enigmr/game-console-1/README.md

## Game Console Project 1

Hobby handheld game console from scratch.

## Top View
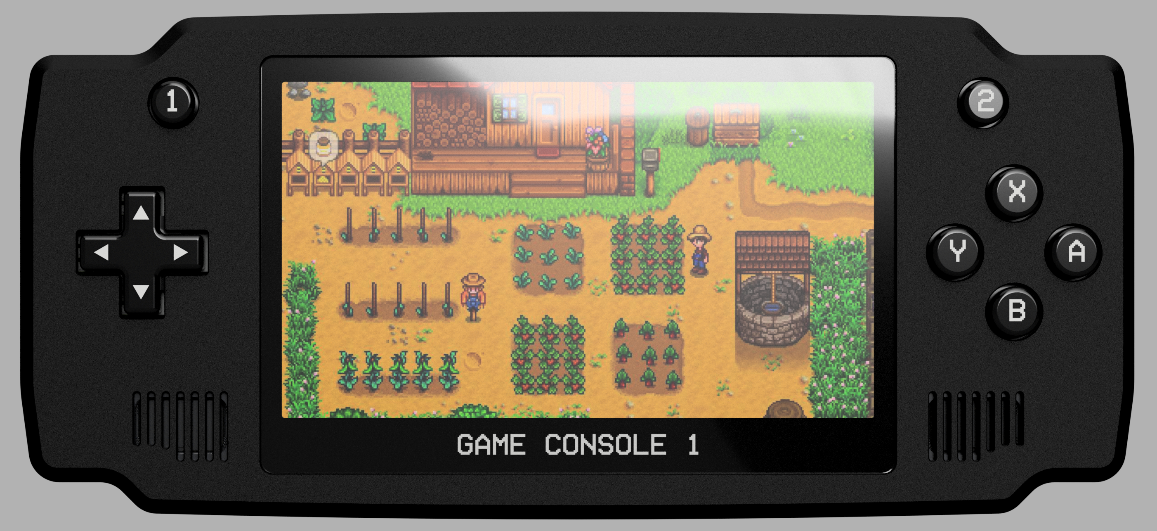
[picture p1: doc/images/mechanicals/render-1.png]


## Insides
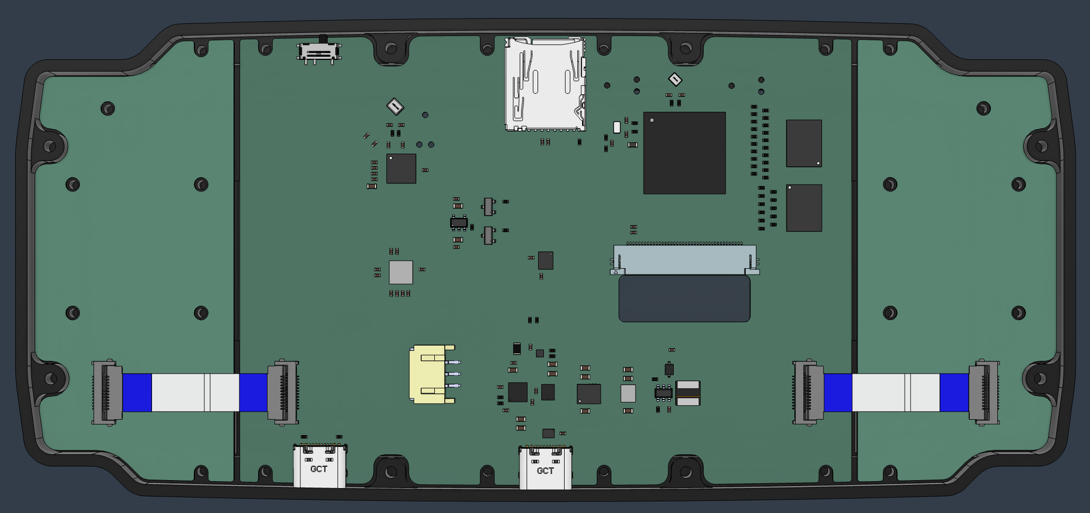
[picture p2: doc/images/mechanicals/insides.png]


## Features

- Display: 4.3", 480x272, 16:9, 1200cd/m2, non-touch
- Processor: STM32N657X0
  - Arm Cortex-M55 @ 800 MHz
  - 2D GPU with scaling, rotating, alpha blending, texture mapping
- RAM:
  - 4.2MB on-chip SRAM
  - 32MB off-chip PSRAM
- Storage:
  - 32MB SLC NOR flash
  - Micro SD card slot
- Audio:
  - Stereo DAC with Class-D amplifiers
  - Stereo 1W speakers
- Haptics:
  - Dual vibration motors
- Input:
  - IMU (accelerometer and gyroscope)
  - D-pad
  - A / B / X / Y buttons
  - Start / Select buttons
- Battery:
  - 500mAh Li-Po battery
- Connectivity:
  - USB-C for charging and accessing storage
  - Wi-Fi and Bluetooth via STM32-C6
- Mechanicals:
  - Machined plastic (material TBD)
- Software:
  - Zephyr RTOS
  - Old game console emulators

## Development Tooling

- Schematics and PCB design: KiCad
- 3D modeling: Fusion 360

## Hardware Block Design

TODO

## PCBs

### Top
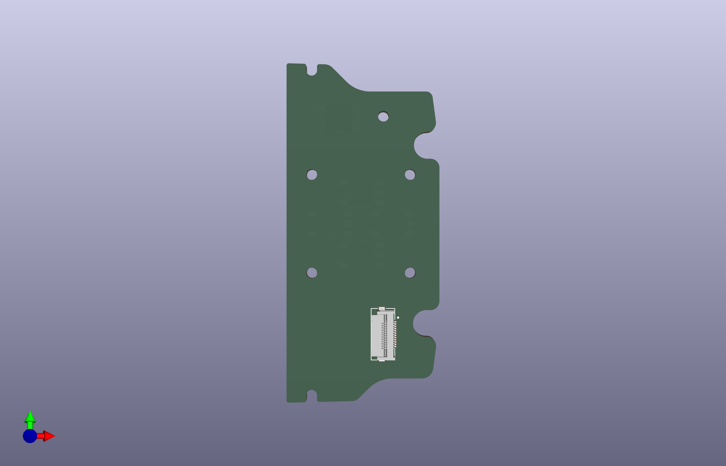
[picture p3: doc/images/pcb/left-board-top.png]

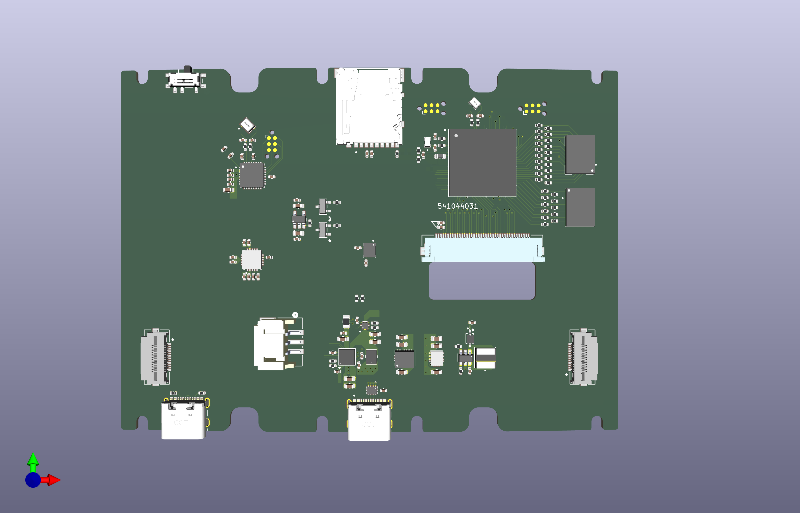
[picture p4: doc/images/pcb/main-board-top.png]

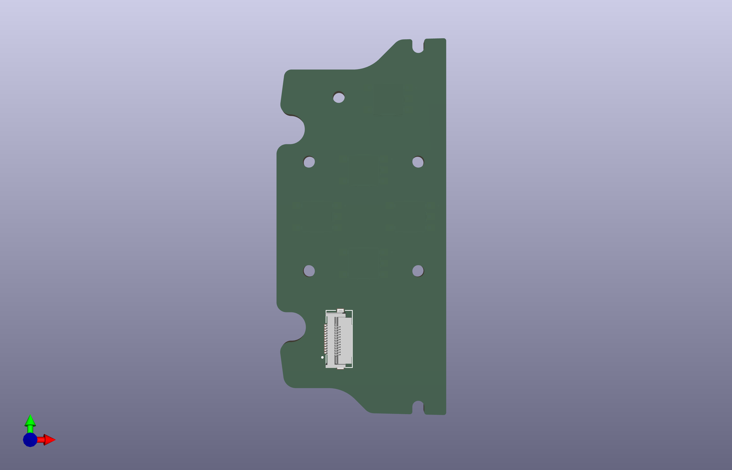
[picture p5: doc/images/pcb/right-board-top.png]


### Top Bottom
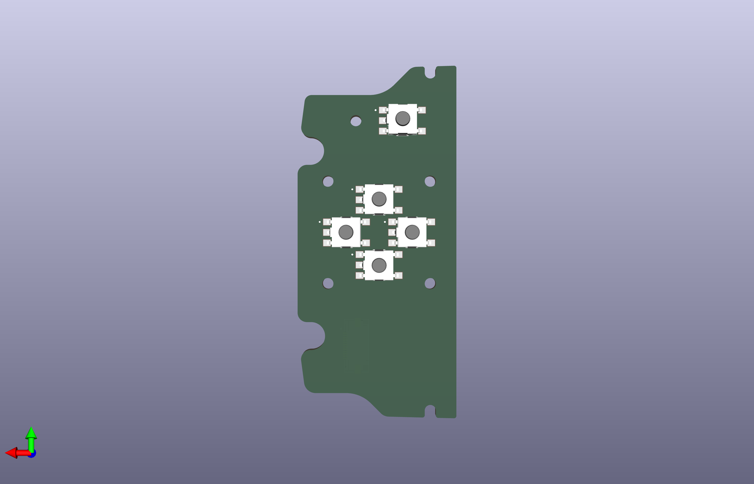
[picture p6: doc/images/pcb/left-board-bottom.png]

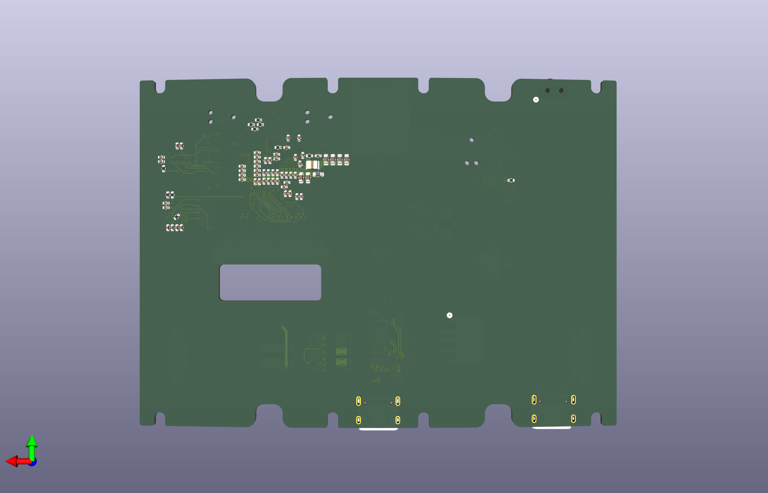
[picture p7: doc/images/pcb/main-board-bottom.png]

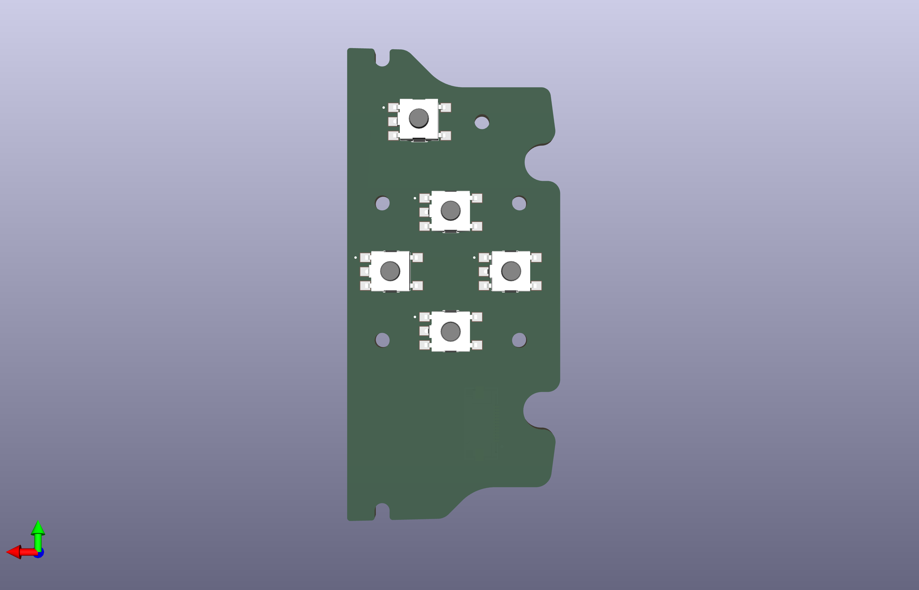
[picture p8: doc/images/pcb/right-board-bottom.png]


## Schematics 

### Top Sheet


### Audio


### ESP32


### Flash


### Haptics


### IMU


### LCD


### MCU


### Micro SD


### Power


### RAM


### USB Switch


### USB


### Controllers


### Left Board


### Right Board
