enigmr/game-console-1/projects/main-board/images/mechanicals/render-1.png

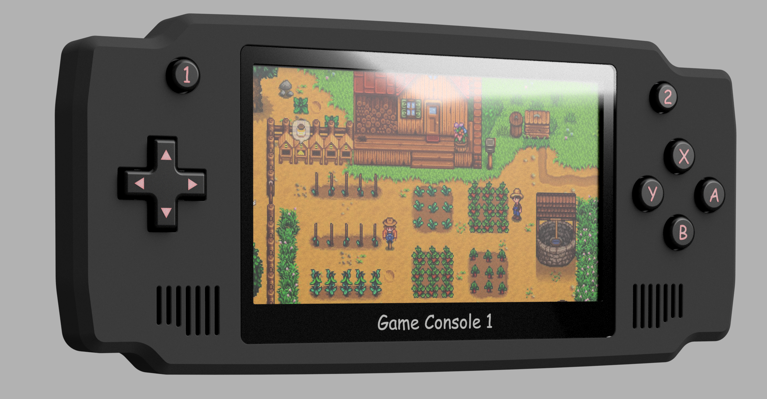
projects/main-board/images/mechanicals/render-1.png
