enigmr/game-console-1/projects/kicad-libraries/3d-models/ABM11W-48.0000MHZ-8-K1Z-T3.stp

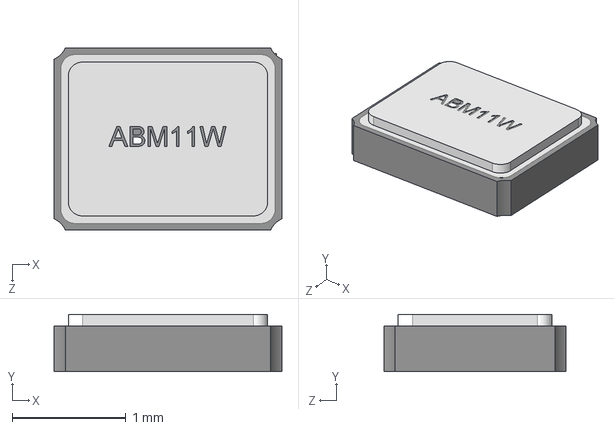
[picture p10: CAD file, 2025-08-03]
projects/kicad-libraries/3d-models/ABM11W-48.0000MHZ-8-K1Z-T3.stp
2.00 x 0.5 x 1.60 mm
