enigmr/game-console-1/projects/kicad-libraries/3d-models/ABS06-32.768KHZ-9-1-T.stp

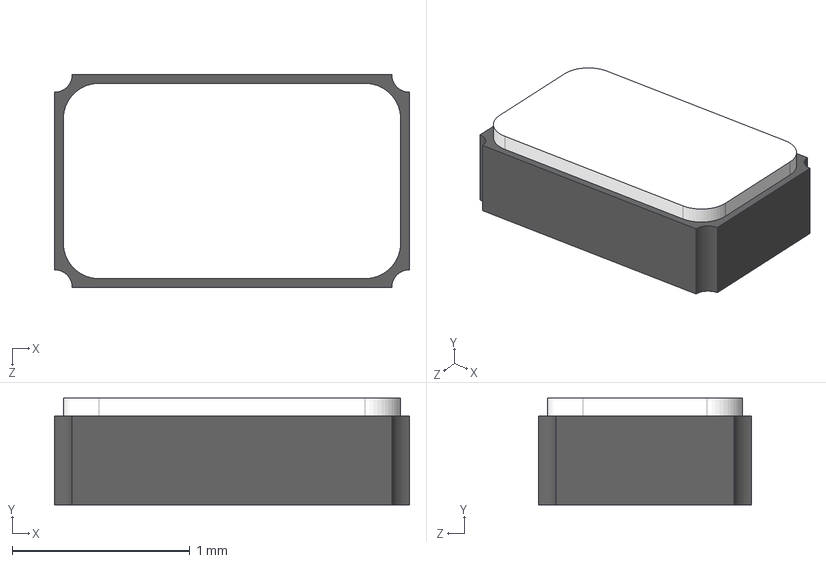
[picture p11: CAD file, 2025-08-03]
projects/kicad-libraries/3d-models/ABS06-32.768KHZ-9-1-T.stp
2.00 x 0.6 x 1.20 mm
