enigmr/game-console-1/projects/kicad-libraries/3d-models/Download_STP_450404015514_rev1.stp

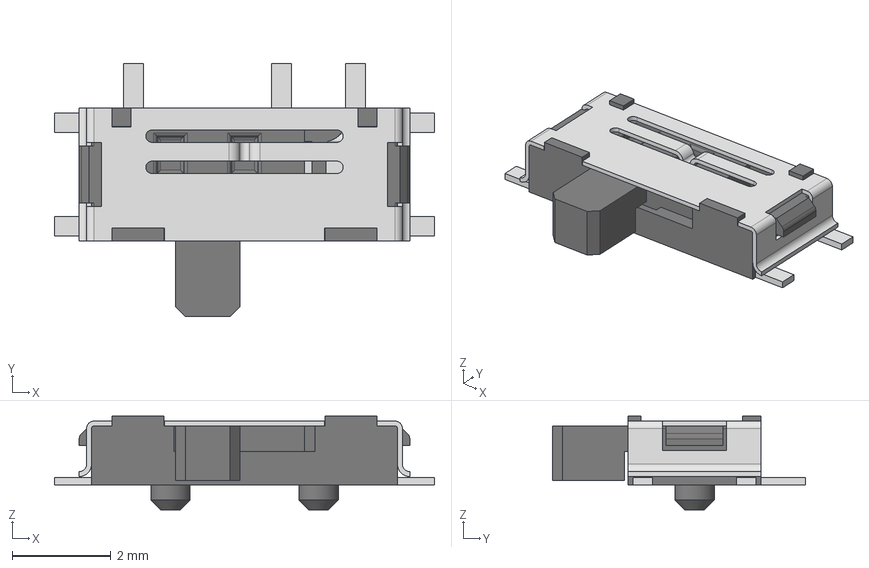
[picture p12: CAD file, 2025-07-27]
projects/kicad-libraries/3d-models/Download_STP_450404015514_rev1.stp
7.70 x 5.13 x 1.90 mm
Frame
Pin 4
Frame 1
Pin 1
Pin 2
Pin 3
Slider 1
Slider
Cover
