enigmr/game-console-1/projects/kicad-libraries/3d-models/IND_0806.step

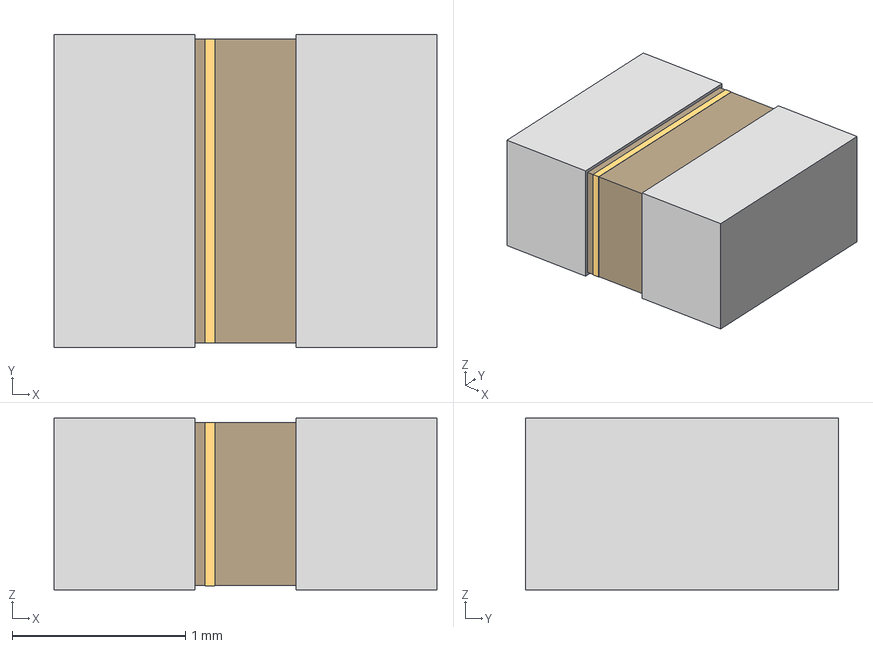
[picture p13: CAD file, 2025-07-27]
projects/kicad-libraries/3d-models/IND_0806.step
2.21 x 1.80 x 0.991 mm
