enigmr/game-console-1/projects/kicad-libraries/3d-models/Same_Sky_TS06-667-25-BK-160-G-SMT-TR.step

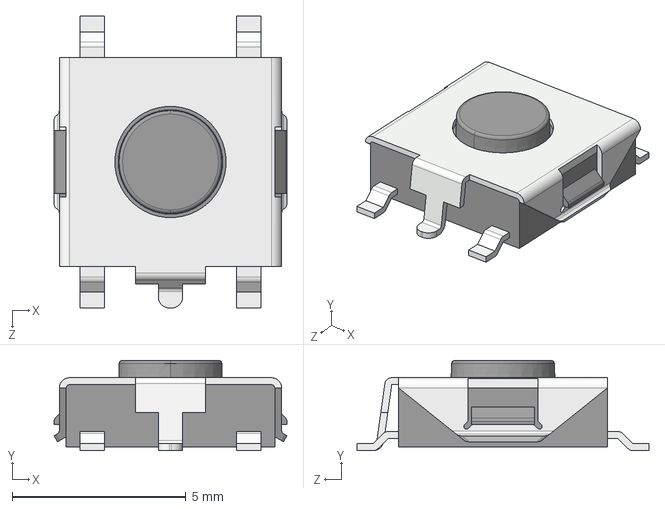
[picture p14: CAD file, 2025-07-27]
projects/kicad-libraries/3d-models/Same_Sky_TS06-667-25-BK-160-G-SMT-TR.step
6.70 x 2.60 x 8.40 mm
