enigmr/game-console-1/projects/kicad-libraries/3d-models/SOD323_DIO.step

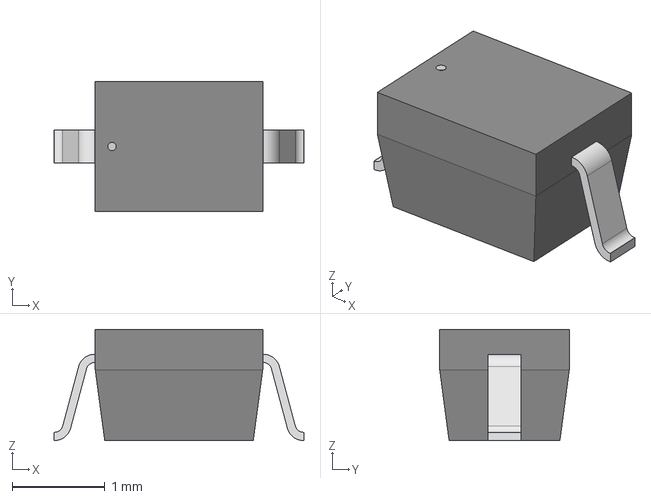
[picture p15: CAD file, 2025-07-27]
projects/kicad-libraries/3d-models/SOD323_DIO.step
2.69 x 1.40 x 1.20 mm
