enigmr/game-console-1/projects/kicad-libraries/3d-models/IND_TAIYO_NR4012_TAY.step

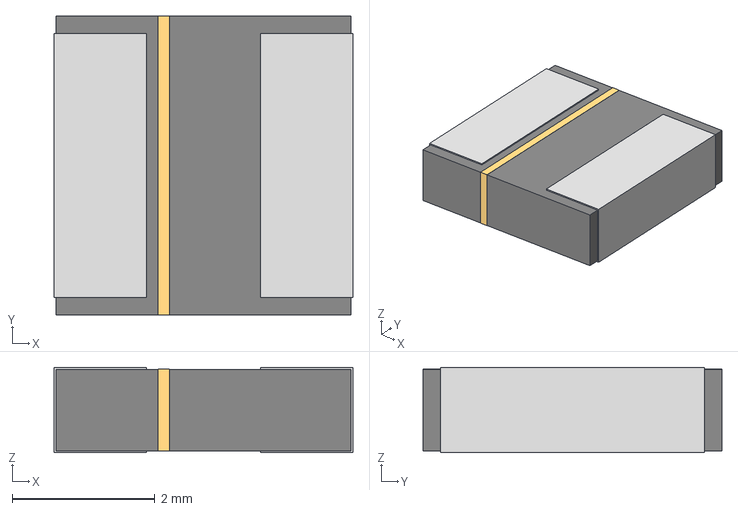
[picture p16: CAD file, 2025-07-27]
projects/kicad-libraries/3d-models/IND_TAIYO_NR4012_TAY.step
4.19 x 4.20 x 1.19 mm
