enigmr/game-console-1/projects/kicad-libraries/3d-models/SOT23_ZXTN_DIO.step

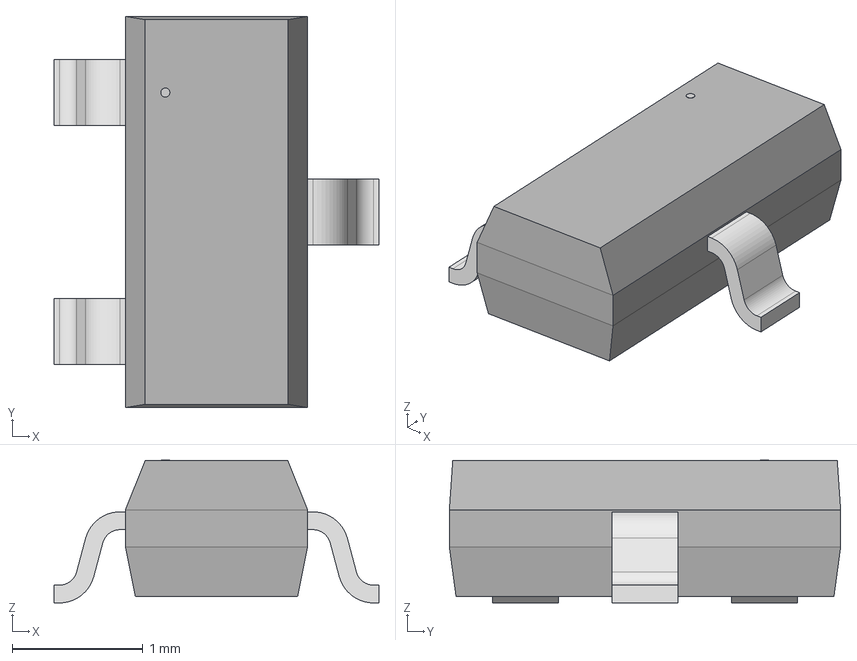
[picture p17: CAD file, 2025-07-27]
projects/kicad-libraries/3d-models/SOT23_ZXTN_DIO.step
2.49 x 3.00 x 1.09 mm
