enigmr/game-console-1/projects/kicad-libraries/3d-models/S3B-PH-SM4-TB_LF__SN_.stp

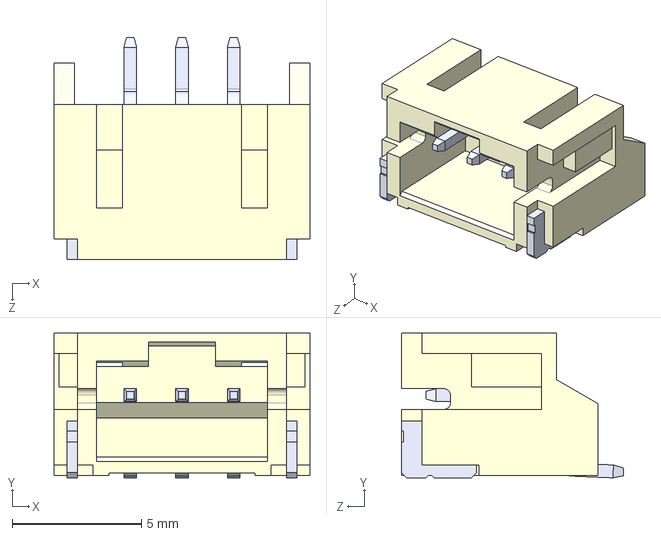
[picture p18: CAD file, 2025-07-27]
projects/kicad-libraries/3d-models/S3B-PH-SM4-TB_LF__SN_.stp
9.90 x 5.60 x 8.60 mm
