enigmr/game-console-1/projects/kicad-libraries/3d-models/IND_HMLQ25201T_CYN.step

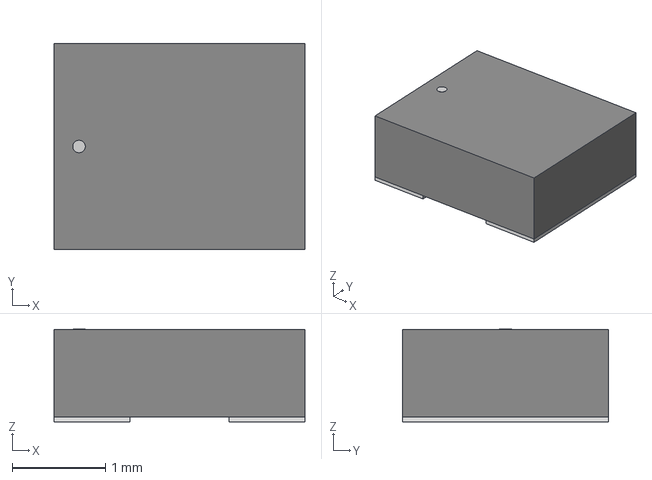
[picture p19: CAD file, 2025-07-27]
projects/kicad-libraries/3d-models/IND_HMLQ25201T_CYN.step
2.69 x 2.21 x 0.993 mm
