enigmr/game-console-1/projects/kicad-libraries/3d-models/STM32N645A0HxQ.step

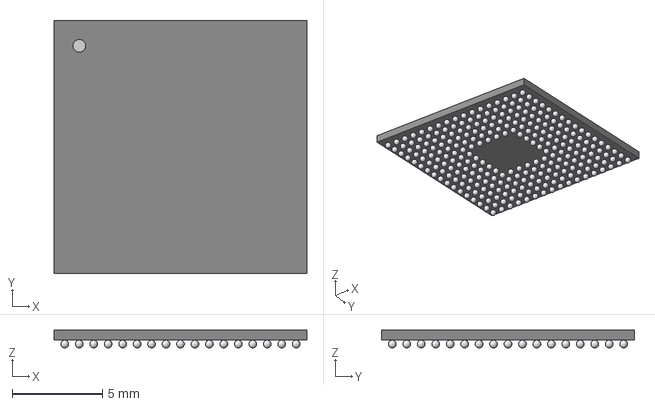
[picture p20: CAD file, 2025-07-26]
projects/kicad-libraries/3d-models/STM32N645A0HxQ.step
14.0 x 14.0 x 0.993 mm
