enigmr/game-console-1/projects/kicad-libraries/3d-models/MX25UM51245GXDI00.STEP

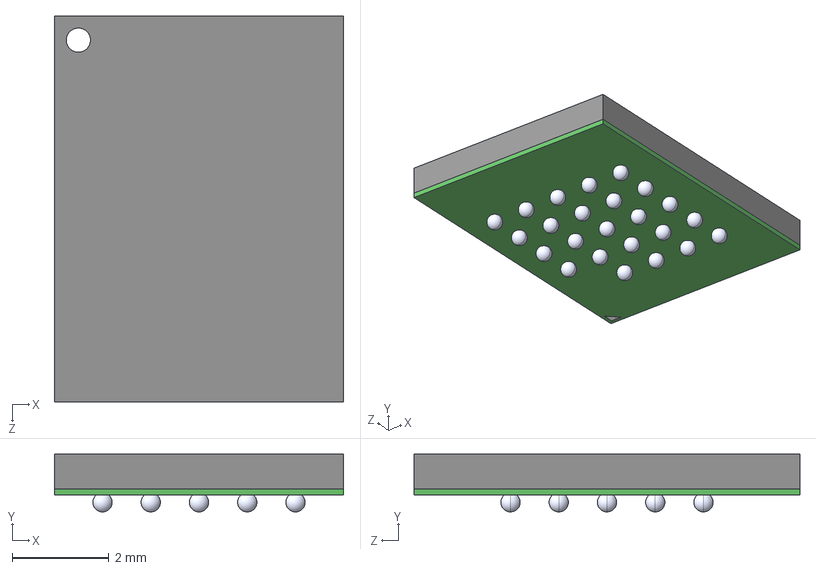
[picture p21: CAD file, 2025-07-26]
projects/kicad-libraries/3d-models/MX25UM51245GXDI00.STEP
6.00 x 1.20 x 8.00 mm
Body^MX25LM51245GXDI00
ball^MX25LM51245GXDI00 x 24
