enigmr/game-console-1/projects/kicad-libraries/3d-models/TPSM863253RDXR--3DModel-STEP-740395.STEP

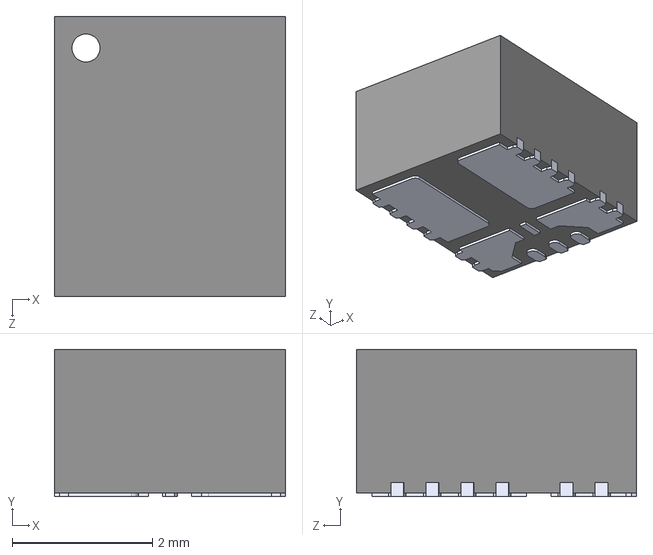
[picture p22: CAD file, 2025-07-26]
projects/kicad-libraries/3d-models/TPSM863253RDXR--3DModel-STEP-740395.STEP
3.30 x 2.10 x 4.00 mm
