enigmr/game-console-1/projects/kicad-libraries/3d-models/AP5725WG-7.STEP

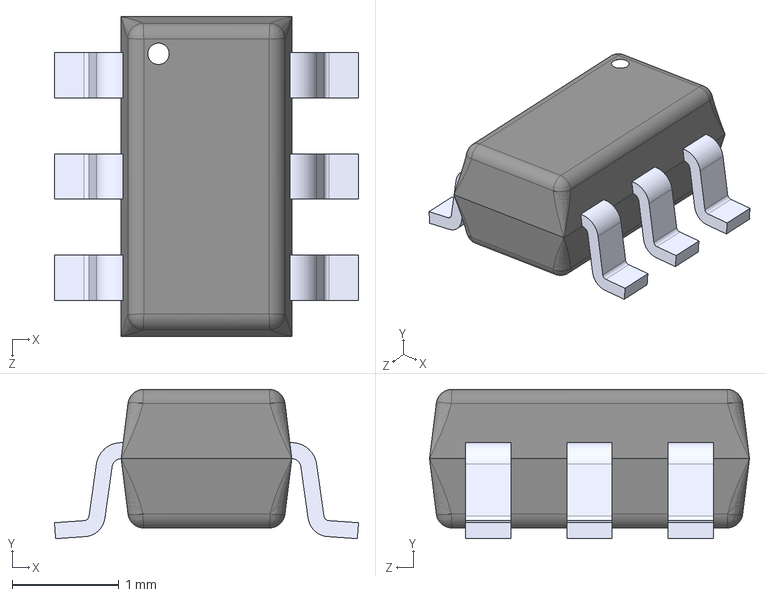
[picture p23: CAD file, 2025-07-26]
projects/kicad-libraries/3d-models/AP5725WG-7.STEP
2.85 x 1.40 x 3.00 mm
