enigmr/game-console-1/projects/kicad-libraries/3d-models/ESP32-C6FH4--3DModel-STEP-56544.STEP

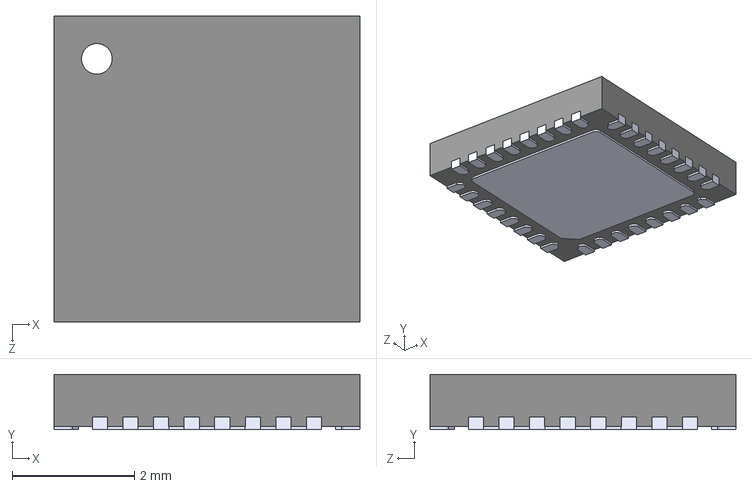
[picture p24: CAD file, 2025-07-26]
projects/kicad-libraries/3d-models/ESP32-C6FH4--3DModel-STEP-56544.STEP
5.00 x 0.9 x 5.00 mm
