enigmr/game-console-1/projects/kicad-libraries/3d-models/APS256XXN-OBR-BG--3DModel-STEP-269445.STEP

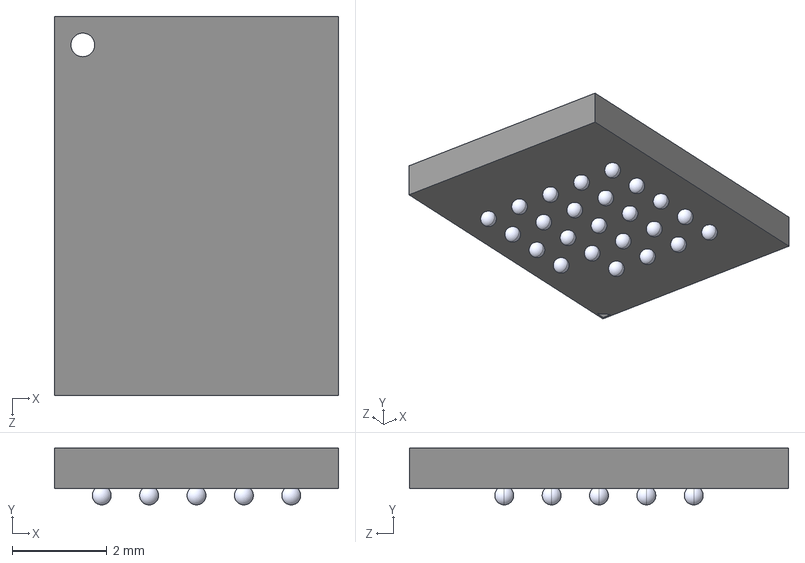
[picture p25: CAD file, 2025-07-26]
projects/kicad-libraries/3d-models/APS256XXN-OBR-BG--3DModel-STEP-269445.STEP
6.00 x 1.20 x 8.00 mm
