enigmr/game-console-1/projects/kicad-libraries/3d-models/LSM6DSO32TR--3DModel-STEP-269445.STEP

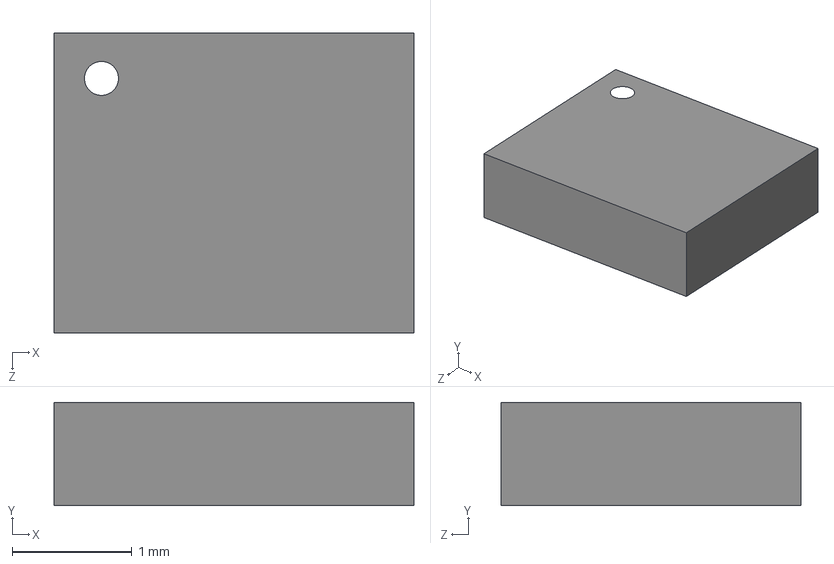
[picture p26: CAD file, 2025-07-26]
projects/kicad-libraries/3d-models/LSM6DSO32TR--3DModel-STEP-269445.STEP
3.00 x 0.86 x 2.50 mm
