enigmr/game-console-1/projects/kicad-libraries/3d-models/MPM3805GQB-18-Z v1.step

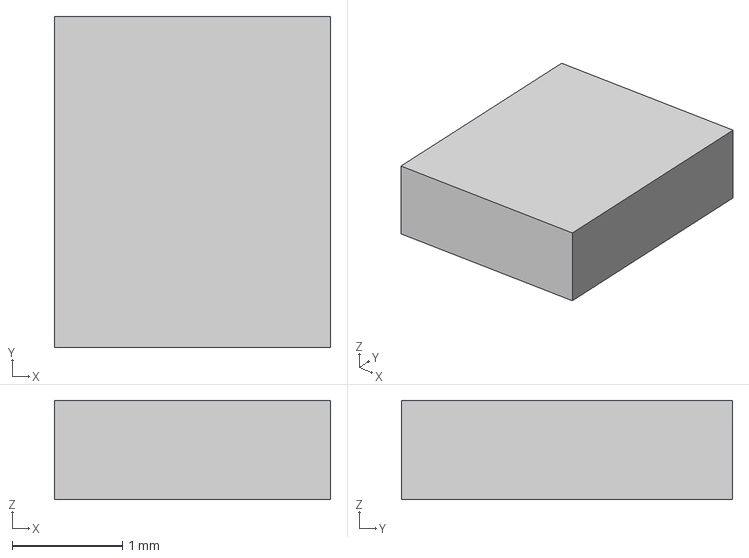
[picture p27: CAD file, 2025-07-26]
projects/kicad-libraries/3d-models/MPM3805GQB-18-Z v1.step
2.50 x 3.00 x 0.9 mm
