enigmr/game-console-1/projects/kicad-libraries/3d-models/USB4105-GF-A.stp

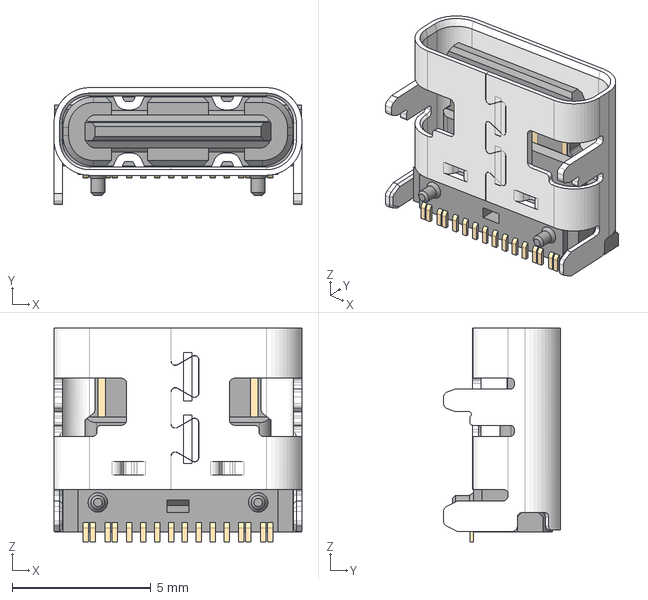
[picture p28: CAD file, 2025-07-26]
projects/kicad-libraries/3d-models/USB4105-GF-A.stp
8.94 x 4.21 x 7.70 mm
USB4105-GF-A_PART1
USB4105-GF-A_PART2
