enigmr/game-console-1/projects/kicad-libraries/3d-models/ABM10W-40.0000MHZ-8-B1U-T3--3DModel-STEP-400430.STEP

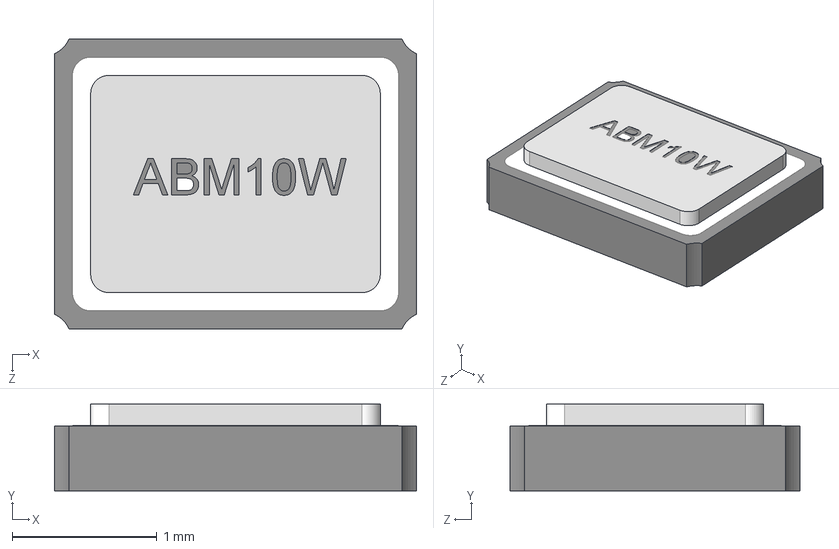
[picture p29: CAD file, 2025-07-26]
projects/kicad-libraries/3d-models/ABM10W-40.0000MHZ-8-B1U-T3--3DModel-STEP-400430.STEP
2.50 x 0.6 x 2.00 mm
