enigmr/game-console-1/projects/kicad-libraries/3d-models/TS3USB221ARSER.STEP

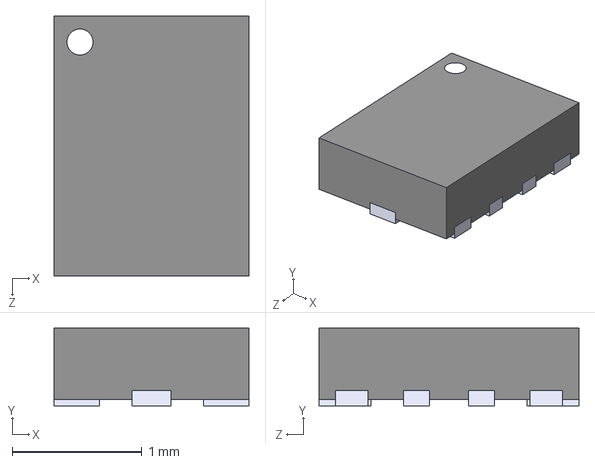
[picture p30: CAD file, 2025-07-26]
projects/kicad-libraries/3d-models/TS3USB221ARSER.STEP
1.50 x 0.6 x 2.00 mm
