enigmr/game-console-1/projects/kicad-libraries/3d-models/dm3at-sf-pejm5.stp

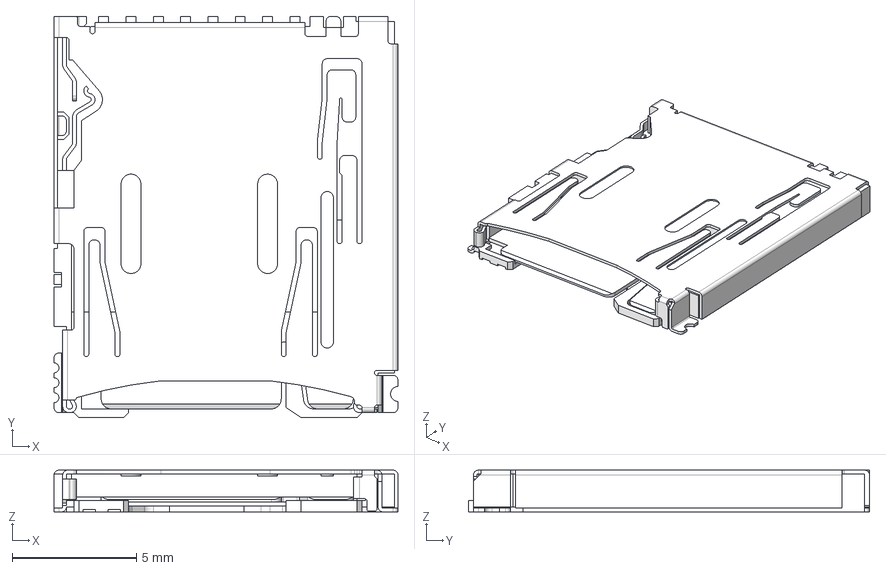
[picture p31: CAD file, 2025-07-26]
projects/kicad-libraries/3d-models/dm3at-sf-pejm5.stp
13.8 x 16.2 x 1.68 mm
