enigmr/game-console-1/(list of files, cad)

Other CAD files:
projects/kicad-libraries/3d-models/5051101292.stp
projects/kicad-libraries/3d-models/541044031.stp
projects/kicad-libraries/3d-models/MAX77972EWX+T.step
projects/kicad-libraries/3d-models/TLV74330PDBVR.STEP
projects/kicad-libraries/3d-models/TPS22992SRXNR--3DModel-STEP-56544.STEP
projects/kicad-libraries/3d-models/TPS92380PWPR--3DModel-STEP-56544.STEP
