enigmr/game-console-1/projects/main-board/main-board.kicad_pcb

## KiCad design projects/main-board/main-board.kicad_pcb (2025-08-25)

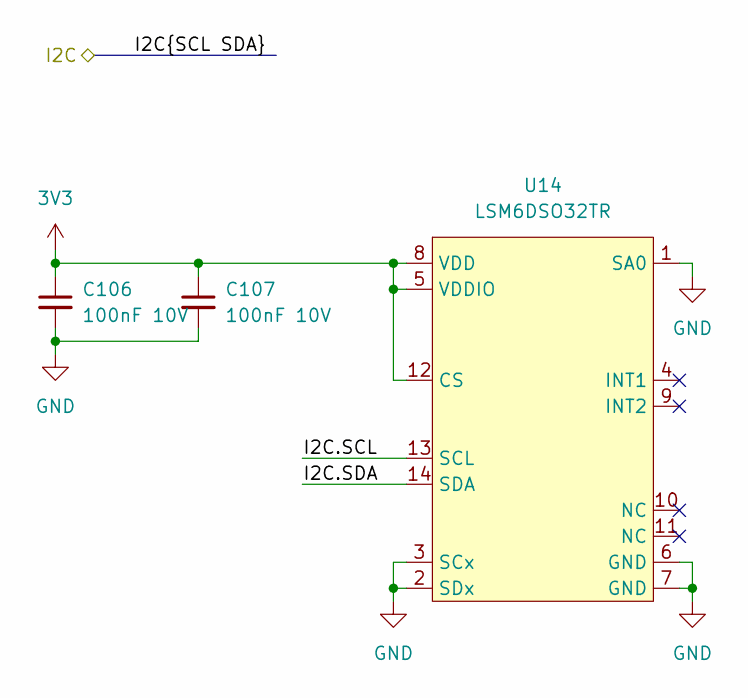
[picture p32: schematic imu.kicad_sch]

Parts:
C106, C107: 100nF 10V; C_0402_1005Metric
U14: LSM6DSO32TR

Connections:
3V3: C106.1, C107.1, U14.5 (VDDIO), U14.8 (VDD), U14.12 (CS); also elsewhere on the board
/Audio/I2C.SCL: U14.13 (SCL); also elsewhere on the board
/Audio/I2C.SDA: U14.14 (SDA); also elsewhere on the board
GND: C106.2, C107.2, U14.1 (SA0), U14.2 (SDx), U14.3 (SCx), U14.6 (GND), U14.7 (GND); also elsewhere on the board

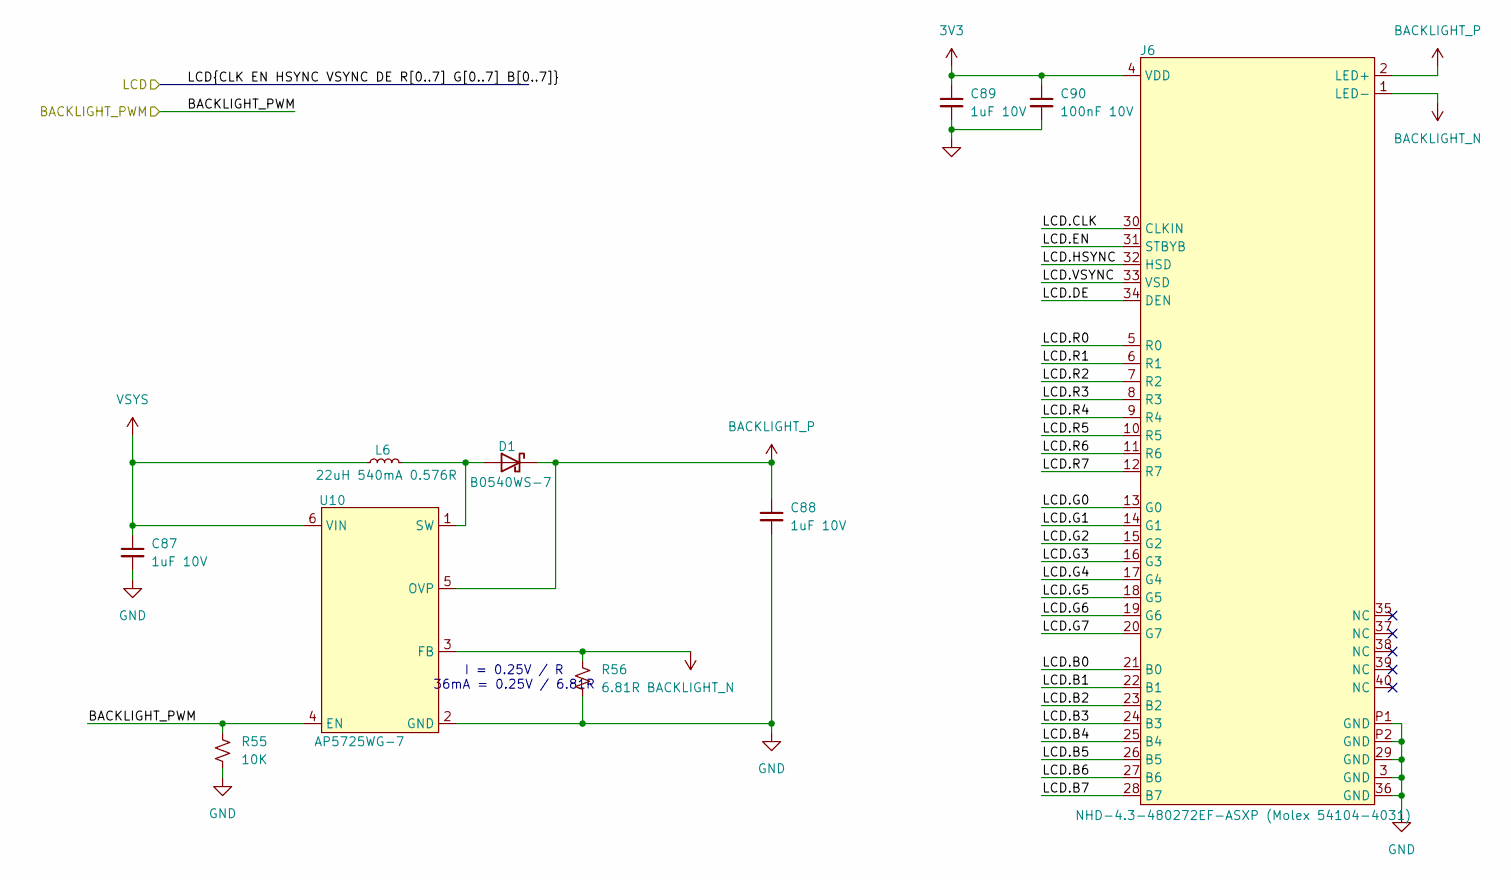
[picture p33: schematic lcd.kicad_sch]

Parts:
C87, C88, C89: 1uF 10V; C_0402_1005Metric
C90: 100nF 10V; C_0402_1005Metric
D1: B0540WS-7; SOD323_DIO
J6: NHD-4.3-480272EF-ASXP (Molex 54104-4031); Molex 54104-4031
L6: 22uH 540mA 0.576R; NR4012T220M
R55: 10K; R_0402_1005Metric
R56: 6.81R; R_0402_1005Metric
U10: AP5725WG-7

Connections:
3V3: C89.1, C90.1, J6.4 (VDD); also elsewhere on the board
/LCD/BACKLIGHT_PWM: R55.1, U10.4 (EN); also elsewhere on the board
/LCD/LCD.B0: J6.21 (B0); also elsewhere on the board
/LCD/LCD.B1: J6.22 (B1); also elsewhere on the board
/LCD/LCD.B2: J6.23 (B2); also elsewhere on the board
/LCD/LCD.B3: J6.24 (B3); also elsewhere on the board
/LCD/LCD.B4: J6.25 (B4); also elsewhere on the board
/LCD/LCD.B5: J6.26 (B5); also elsewhere on the board
/LCD/LCD.B6: J6.27 (B6); also elsewhere on the board
/LCD/LCD.B7: J6.28 (B7); also elsewhere on the board
/LCD/LCD.CLK: J6.30 (CLKIN); also elsewhere on the board
/LCD/LCD.DE: J6.34 (DEN); also elsewhere on the board
/LCD/LCD.EN: J6.31 (STBYB); also elsewhere on the board
/LCD/LCD.G0: J6.13 (G0); also elsewhere on the board
/LCD/LCD.G1: J6.14 (G1); also elsewhere on the board
/LCD/LCD.G2: J6.15 (G2); also elsewhere on the board
/LCD/LCD.G3: J6.16 (G3); also elsewhere on the board
/LCD/LCD.G4: J6.17 (G4); also elsewhere on the board
/LCD/LCD.G5: J6.18 (G5); also elsewhere on the board
/LCD/LCD.G6: J6.19 (G6); also elsewhere on the board
/LCD/LCD.G7: J6.20 (G7); also elsewhere on the board
/LCD/LCD.HSYNC: J6.32 (HSD); also elsewhere on the board
/LCD/LCD.R0: J6.5 (R0); also elsewhere on the board
/LCD/LCD.R1: J6.6 (R1); also elsewhere on the board
/LCD/LCD.R2: J6.7 (R2); also elsewhere on the board
/LCD/LCD.R3: J6.8 (R3); also elsewhere on the board
/LCD/LCD.R4: J6.9 (R4); also elsewhere on the board
/LCD/LCD.R5: J6.10 (R5); also elsewhere on the board
/LCD/LCD.R6: J6.11 (R6); also elsewhere on the board
/LCD/LCD.R7: J6.12 (R7); also elsewhere on the board
/LCD/LCD.VSYNC: J6.33 (VSD); also elsewhere on the board
BACKLIGHT_N: J6.1 (LED-), R56.1, U10.3 (FB)
BACKLIGHT_P: C88.1, D1.1 (K), J6.2 (LED+), U10.5 (OVP)
GND: C87.2, C88.2, C89.2, C90.2, J6.3 (GND), J6.29 (GND), J6.36 (GND), J6.P1 (GND), J6.P2 (GND), R55.2, R56.2, U10.2 (GND); also elsewhere on the board
unnamed: D1.2 (A), L6.2, U10.1 (SW)
VSYS: C87.1, L6.1, U10.6 (VIN); also elsewhere on the board

Notes on the sheet:
I = 0.25V / R 36mA = 0.25V / 6.81R

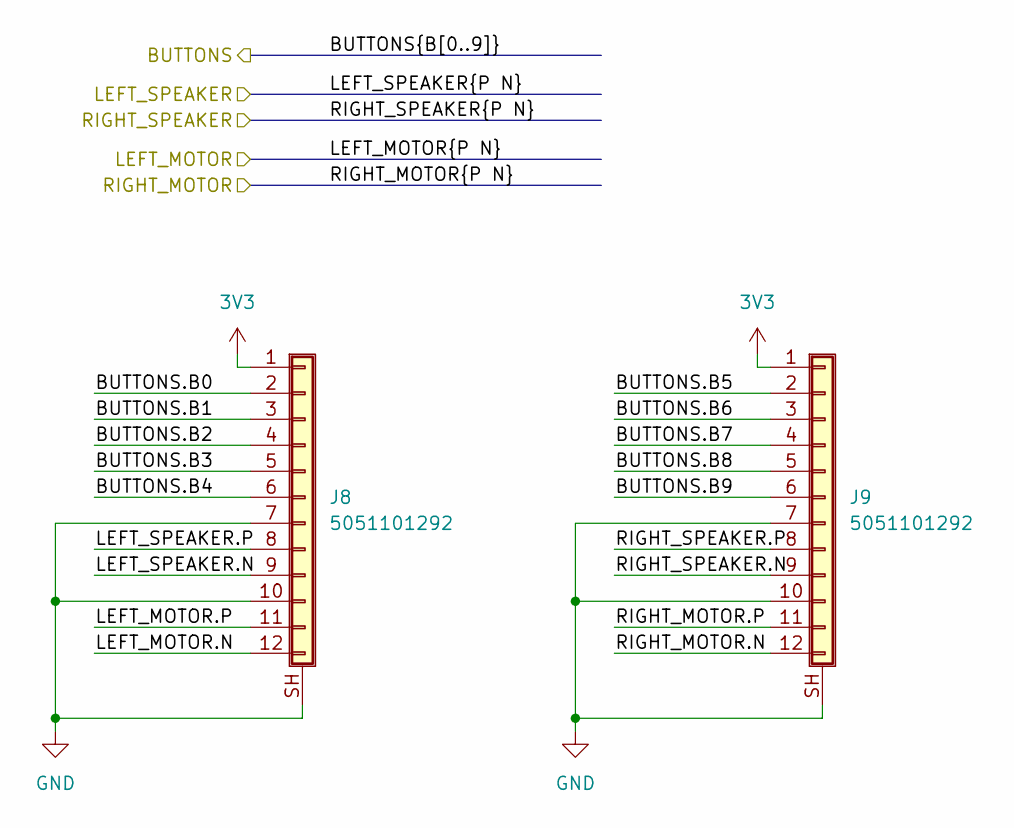
[picture p34: schematic controllers.kicad_sch]

Parts:
J8, J9: 5051101292

Connections:
3V3: J8.1, J9.1; also elsewhere on the board
/Audio/LEFT_SPEAKER.N: J8.9; also elsewhere on the board
/Audio/LEFT_SPEAKER.P: J8.8; also elsewhere on the board
/Audio/RIGHT_SPEAKER.N: J9.9; also elsewhere on the board
/Audio/RIGHT_SPEAKER.P: J9.8; also elsewhere on the board
/Controllers/BUTTONS.B0: J8.2; also elsewhere on the board
/Controllers/BUTTONS.B1: J8.3; also elsewhere on the board
/Controllers/BUTTONS.B2: J8.4; also elsewhere on the board
/Controllers/BUTTONS.B3: J8.5; also elsewhere on the board
/Controllers/BUTTONS.B4: J8.6; also elsewhere on the board
/Controllers/BUTTONS.B5: J9.2; also elsewhere on the board
/Controllers/BUTTONS.B6: J9.3; also elsewhere on the board
/Controllers/BUTTONS.B7: J9.4; also elsewhere on the board
/Controllers/BUTTONS.B8: J9.5; also elsewhere on the board
/Controllers/BUTTONS.B9: J9.6; also elsewhere on the board
/Controllers/LEFT_MOTOR.N: J8.12; also elsewhere on the board
/Controllers/LEFT_MOTOR.P: J8.11; also elsewhere on the board
/Controllers/RIGHT_MOTOR.N: J9.12; also elsewhere on the board
/Controllers/RIGHT_MOTOR.P: J9.11
GND: J8.7, J8.10, J8.SH (Shield), J9.7, J9.10, J9.SH (Shield); also elsewhere on the board

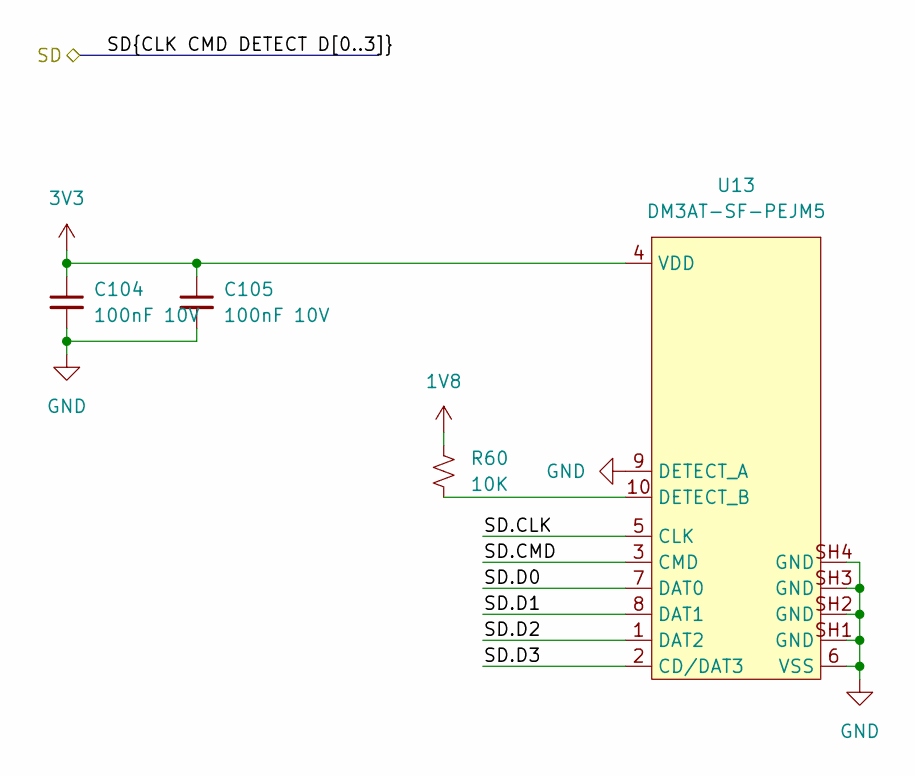
[picture p35: schematic micro-sd.kicad_sch]

Parts:
C104, C105: 100nF 10V; C_0402_1005Metric
R60: 10K; R_0402_1005Metric
U13: DM3AT-SF-PEJM5

Connections:
1V8: R60.1; also elsewhere on the board
3V3: C104.1, C105.1, U13.4 (VDD); also elsewhere on the board
/MCU/SD.CLK: U13.5 (CLK); also elsewhere on the board
/MCU/SD.CMD: U13.3 (CMD); also elsewhere on the board
/MCU/SD.D0: U13.7 (DAT0); also elsewhere on the board
/MCU/SD.D1: U13.8 (DAT1); also elsewhere on the board
/MCU/SD.D2: U13.1 (DAT2); also elsewhere on the board
/MCU/SD.D3: U13.2 (CD/DAT3); also elsewhere on the board
GND: C104.2, C105.2, U13.6 (VSS), U13.9 (DETECT_A), U13.SH1 (GND), U13.SH2 (GND), U13.SH3 (GND), U13.SH4 (GND); also elsewhere on the board
unnamed: R60.2, U13.10 (DETECT_B)

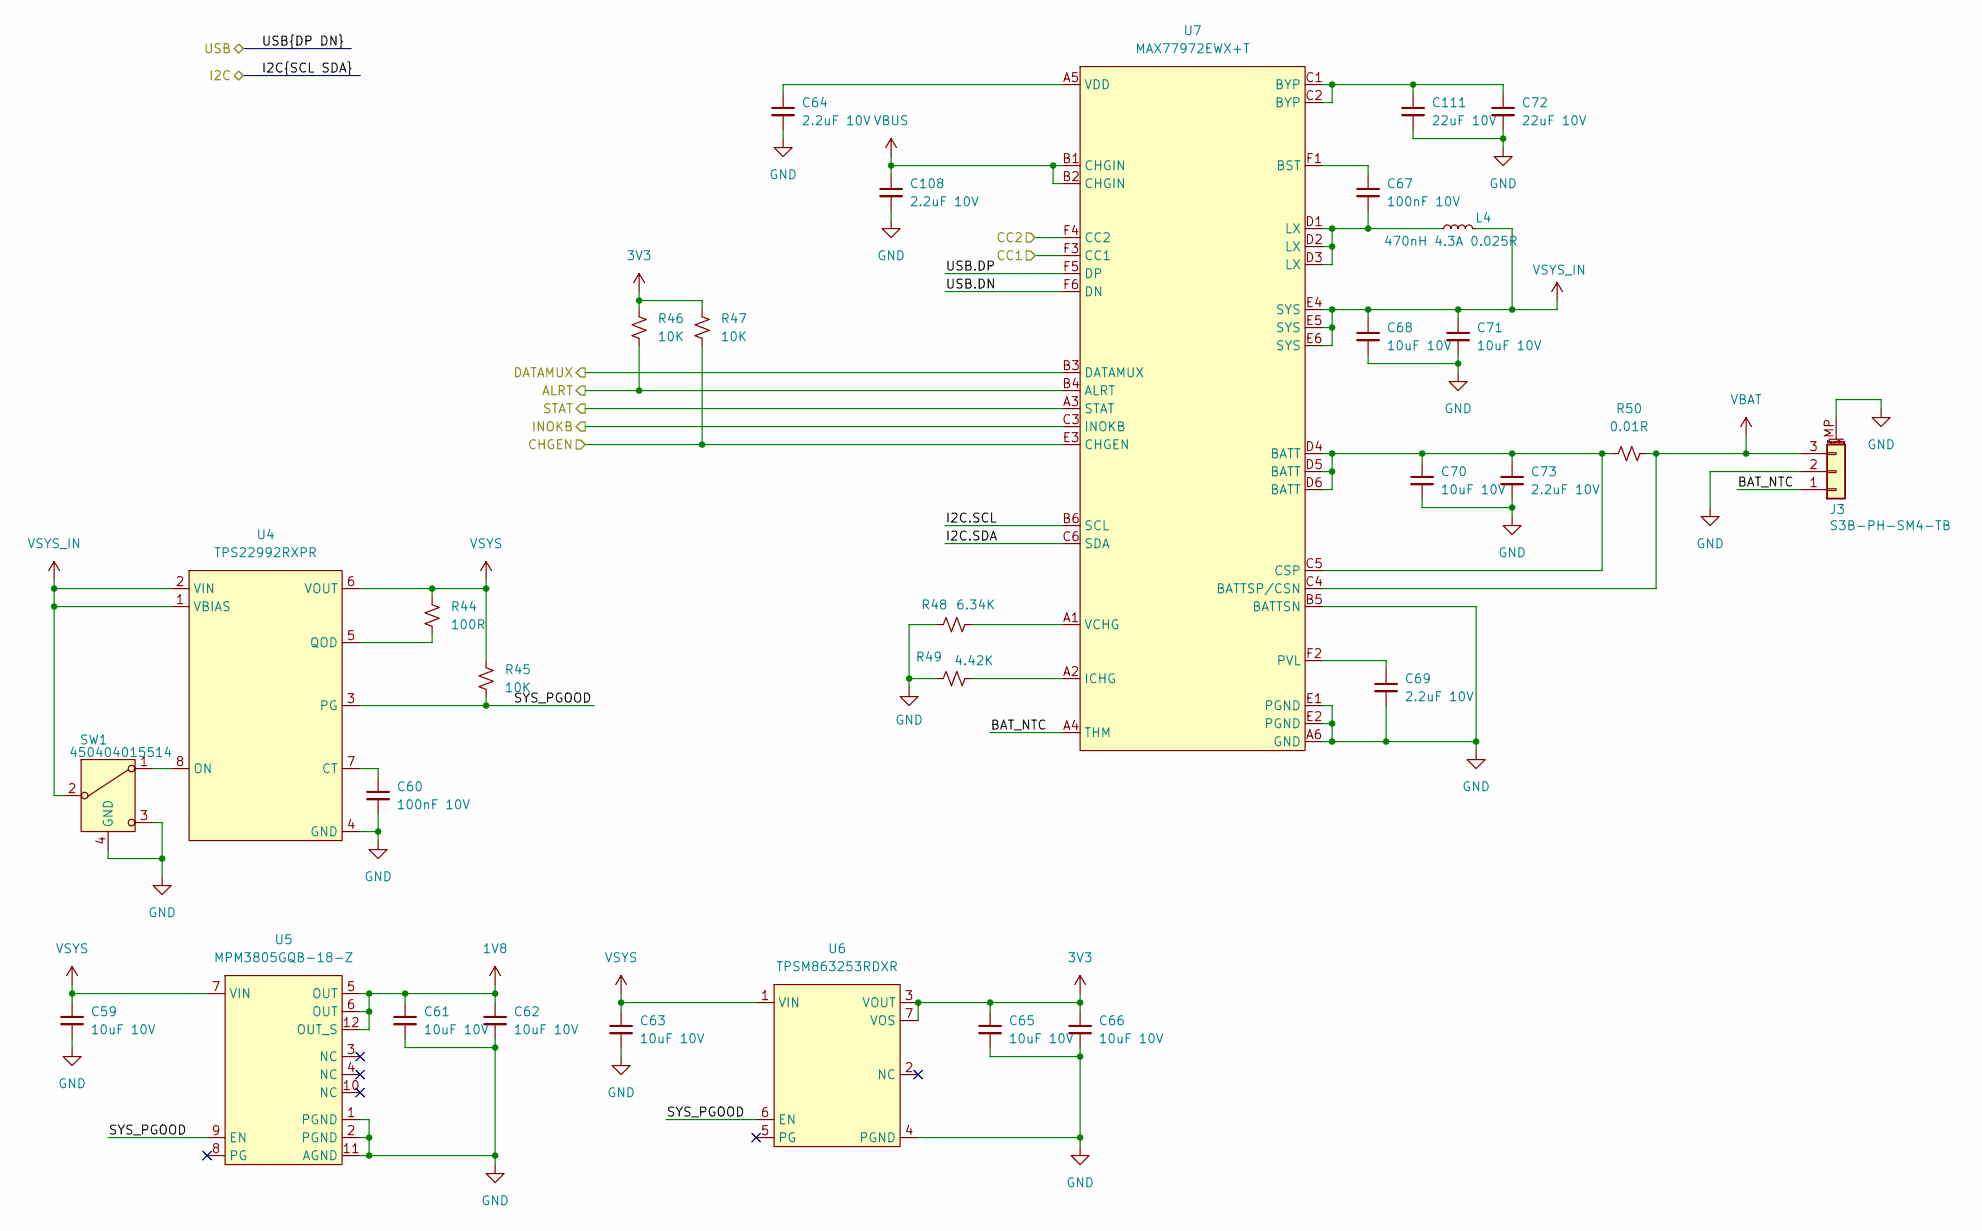
[picture p36: schematic pmic.kicad_sch]

Parts:
C59, C61, C62, C63, C65, C66, C68, C70, C71: 10uF 10V; C_0603_1608Metric
C60, C67: 100nF 10V; C_0402_1005Metric
C64, C69, C73, C108: 2.2uF 10V; C_0402_1005Metric
C72, C111: 22uF 10V; C_0603_1608Metric
J3: S3B-PH-SM4-TB
L4: 470nH 4.3A 0.025R; HMLQ25201T-R47MSR
R44: 100R; R_0402_1005Metric
R45, R46, R47: 10K; R_0402_1005Metric
R48: 6.34K; R_0402_1005Metric
R49: 4.42K; R_0402_1005Metric
R50: 0.01R; R_0805_2012Metric
SW1: 450404015514
U4: TPS22992RXPR
U5: MPM3805GQB-18-Z
U6: TPSM863253RDXR
U7: MAX77972EWX+T

Connections:
1V8: C61.1, C62.1, U5.5 (OUT), U5.6 (OUT), U5.12 (OUT_S); also elsewhere on the board
3V3: C65.1, C66.1, R46.1, R47.1, U6.3 (VOUT), U6.7 (VOS); also elsewhere on the board
/MCU/I2C4.SCL: U7.B6 (SCL); also elsewhere on the board
/MCU/I2C4.SDA: U7.C6 (SDA); also elsewhere on the board
/MCU/PMIC_ALERT: R46.2, U7.B4 (ALRT); also elsewhere on the board
/MCU/PMIC_CHARGE_EN: R47.2, U7.E3 (CHGEN); also elsewhere on the board
/MCU/PMIC_INPUT_VALID: U7.C3 (INOKB); also elsewhere on the board
/MCU/PMIC_STATUS: U7.A3 (STAT); also elsewhere on the board
/Power/BAT_NTC: J3.1, U7.A4 (THM)
/Power/DATAMUX: U7.B3 (DATAMUX); also elsewhere on the board
/Power/SYS_PGOOD: R45.2, U4.3 (PG), U5.9 (EN), U6.6 (EN)
/Power/USB.DN: U7.F6 (DN); also elsewhere on the board
/Power/USB.DP: U7.F5 (DP); also elsewhere on the board
/USB/USB_CC1: U7.F3 (CC1); also elsewhere on the board
/USB/USB_CC2: U7.F4 (CC2); also elsewhere on the board
GND: C59.2, C60.2, C61.2, C62.2, C63.2, C64.2, C65.2, C66.2, C68.2, C69.2, C70.2, C71.2, C72.2, C73.2, C108.2, C111.2, J3.2, J3.MP (MountPin), R48.1, R49.1, SW1.3, SW1.4 (GND), U4.4 (GND), U5.1 (PGND), U5.2 (PGND), U5.11 (AGND), U6.4 (PGND), U7.A6 (GND), U7.B5 (BATTSN), U7.E1 (PGND), U7.E2 (PGND); also elsewhere on the board
unnamed: C67.2, L4.1, U7.D1 (LX), U7.D2 (LX), U7.D3 (LX)
unnamed: C72.1, C111.1, U7.C1 (BYP), U7.C2 (BYP)
unnamed: C60.1, U4.7 (CT)
unnamed: SW1.1, U4.8 (ON)
unnamed: R44.2, U4.5 (QOD)
unnamed: C67.1, U7.F1 (BST)
unnamed: C70.1, C73.1, R50.1, U7.C5 (CSP), U7.D4 (BATT), U7.D5 (BATT), U7.D6 (BATT)
unnamed: R49.2, U7.A2 (ICHG)
unnamed: C69.1, U7.F2 (PVL)
unnamed: R48.2, U7.A1 (VCHG)
unnamed: C64.1, U7.A5 (VDD)
VBAT: J3.3, R50.2, U7.C4 (BATTSP/CSN); also elsewhere on the board
VBUS: C108.1, U7.B1 (CHGIN), U7.B2 (CHGIN); also elsewhere on the board
VSYS: C59.1, C63.1, R44.1, R45.1, U4.6 (VOUT), U5.7 (VIN), U6.1 (VIN); also elsewhere on the board
VSYS_IN: C68.1, C71.1, L4.2, SW1.2, U4.1 (VBIAS), U4.2 (VIN), U7.E4 (SYS), U7.E5 (SYS), U7.E6 (SYS)

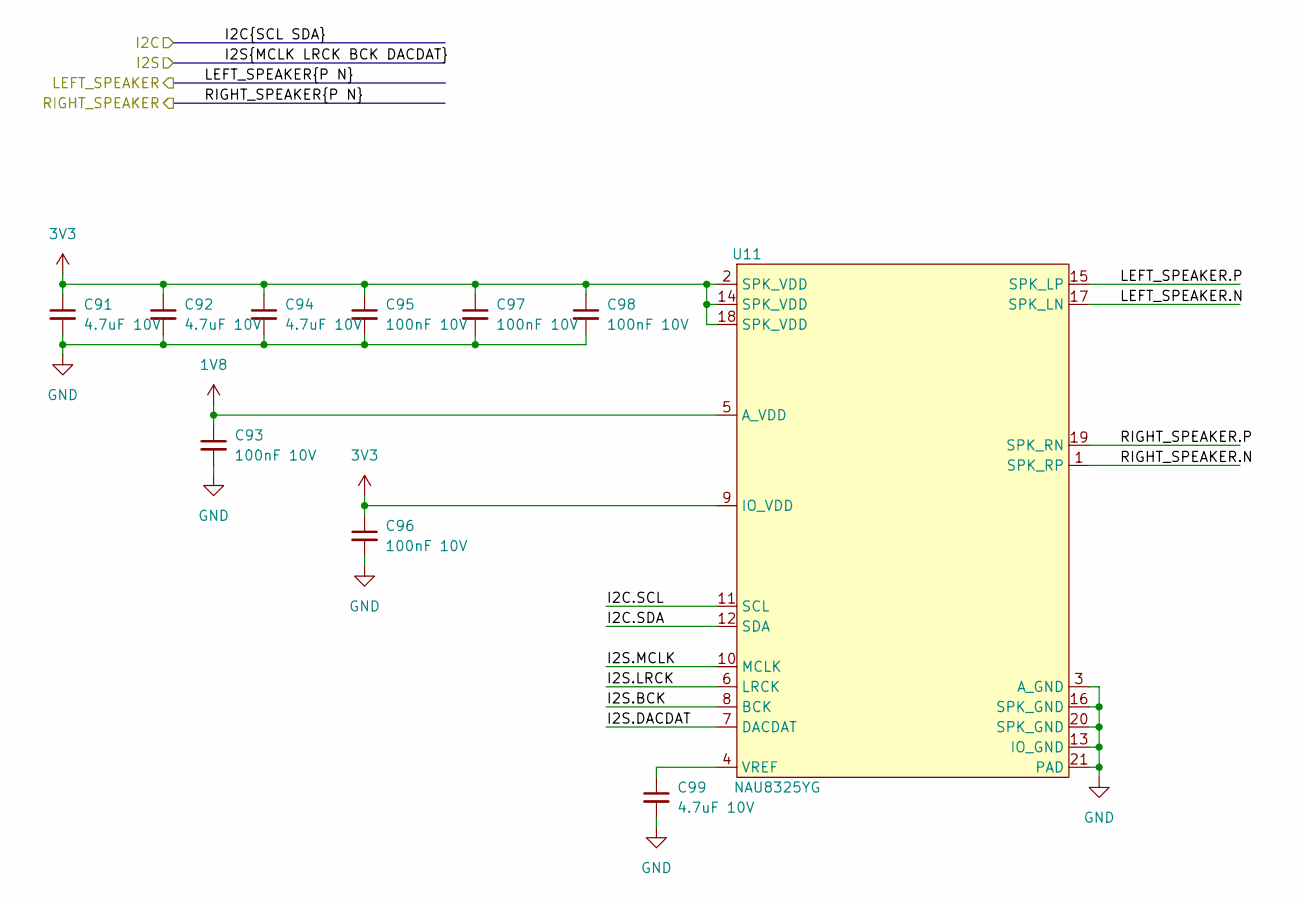
[picture p37: schematic audio.kicad_sch]

Parts:
C91, C92, C94, C99: 4.7uF 10V; C_0402_1005Metric
C93, C95, C96, C97, C98: 100nF 10V; C_0402_1005Metric
U11: NAU8325YG

Connections:
1V8: C93.1, U11.5 (A_VDD); also elsewhere on the board
3V3: C91.1, C92.1, C94.1, C95.1, C96.1, C97.1, C98.1, U11.2 (SPK_VDD), U11.9 (IO_VDD), U11.14 (SPK_VDD), U11.18 (SPK_VDD); also elsewhere on the board
/Audio/I2C.SCL: U11.11 (SCL); also elsewhere on the board
/Audio/I2C.SDA: U11.12 (SDA); also elsewhere on the board
/Audio/I2S.BCK: U11.8 (BCK); also elsewhere on the board
/Audio/I2S.DACDAT: U11.7 (DACDAT); also elsewhere on the board
/Audio/I2S.LRCK: U11.6 (LRCK); also elsewhere on the board
/Audio/I2S.MCLK: U11.10 (MCLK); also elsewhere on the board
/Audio/LEFT_SPEAKER.N: U11.17 (SPK_LN); also elsewhere on the board
/Audio/LEFT_SPEAKER.P: U11.15 (SPK_LP); also elsewhere on the board
/Audio/RIGHT_SPEAKER.N: U11.1 (SPK_RP); also elsewhere on the board
/Audio/RIGHT_SPEAKER.P: U11.19 (SPK_RN); also elsewhere on the board
GND: C91.2, C92.2, C93.2, C94.2, C95.2, C96.2, C97.2, C98.2, C99.2, U11.3 (A_GND), U11.13 (IO_GND), U11.16 (SPK_GND), U11.20 (SPK_GND), U11.21 (PAD); also elsewhere on the board
unnamed: C99.1, U11.4 (VREF)

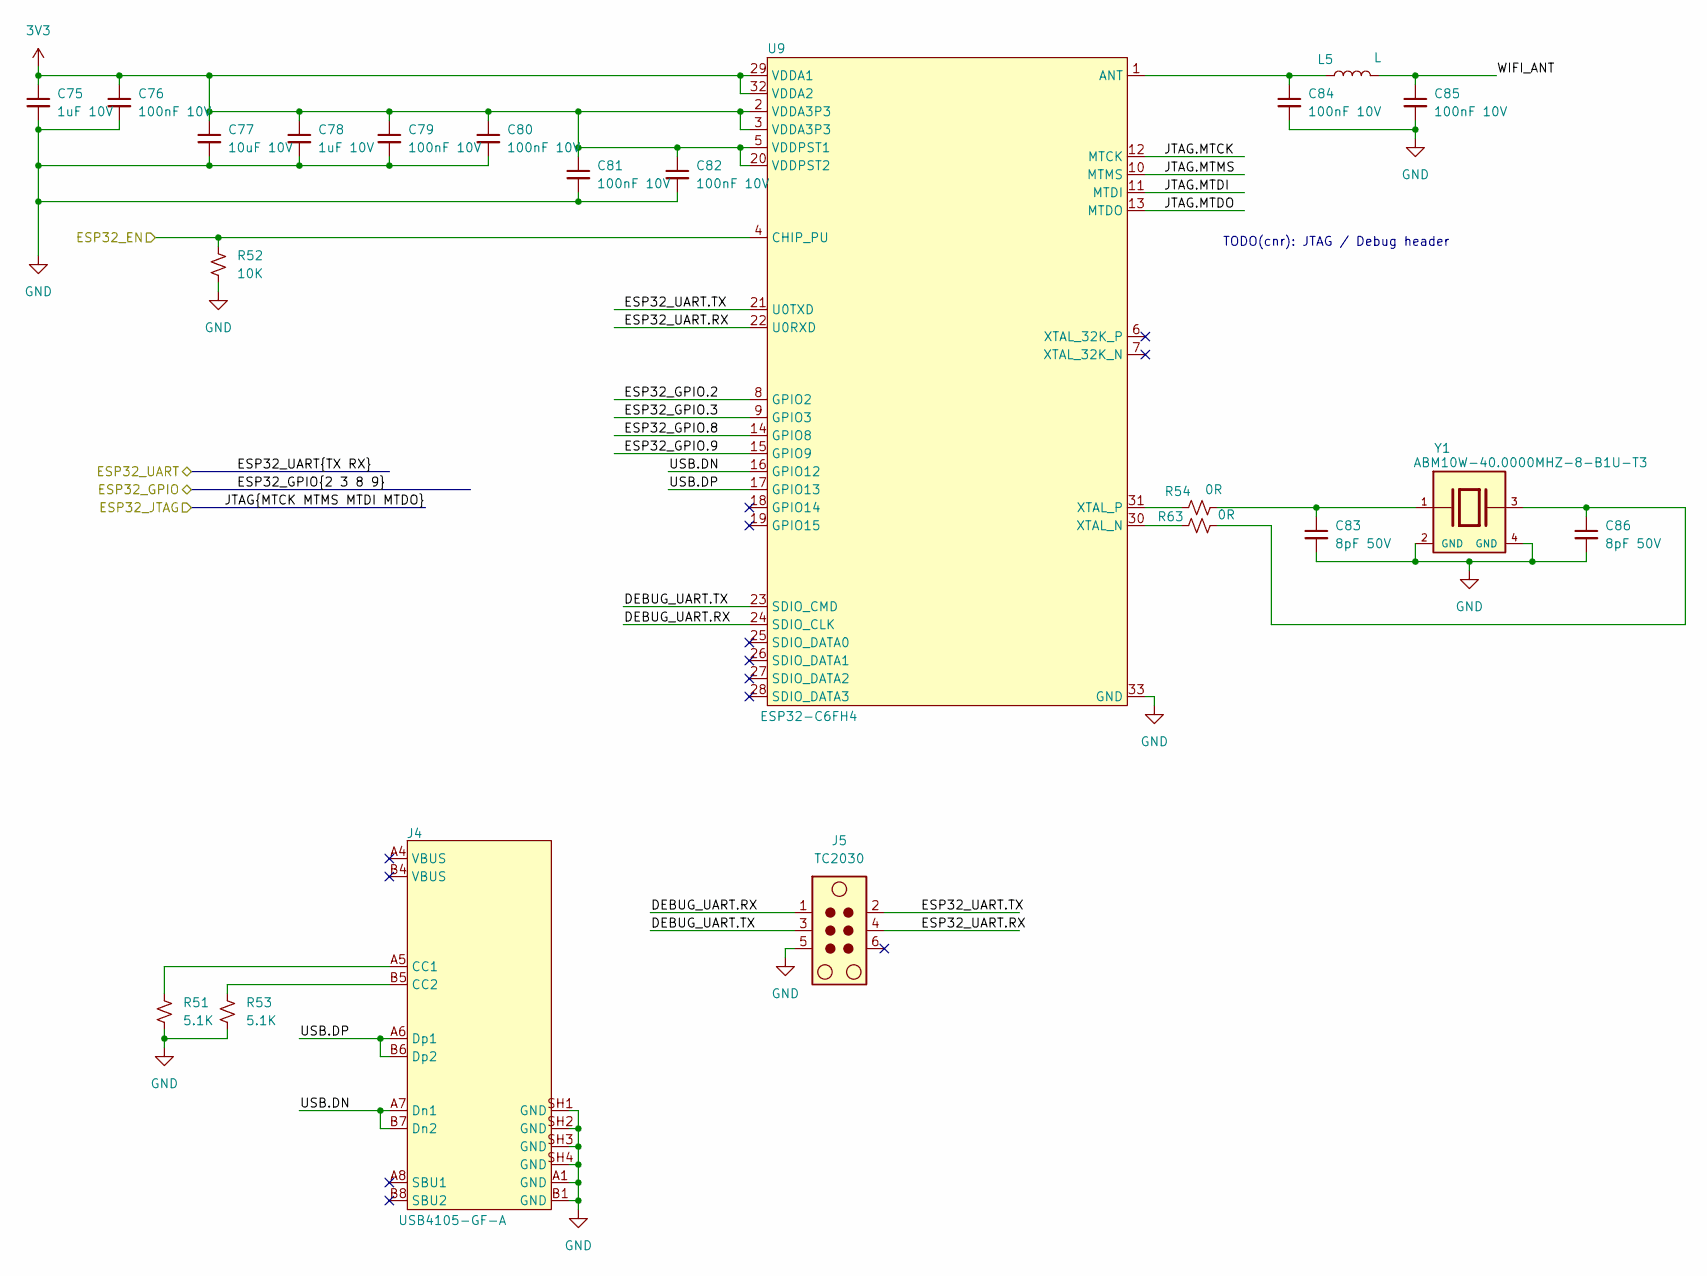
[picture p38: schematic esp32.kicad_sch]

Parts:
C75, C78: 1uF 10V; C_0402_1005Metric
C76, C79, C80, C81, C82, C84, C85: 100nF 10V; C_0402_1005Metric
C77: 10uF 10V; C_0603_1608Metric
C83, C86: 8pF 50V; C_0402_1005Metric
J4: USB4105-GF-A
J5: TC2030; Tag-Connect_TC2030-IDC-NL_2x03_P1.27mm_Vertical
L5: L
R51, R53: 5.1K; R_0402_1005Metric
R52: 10K; R_0402_1005Metric
R54, R63: 0R; R_0402_1005Metric
U9: ESP32-C6FH4
Y1: ABM10W-40.0000MHZ-8-B1U-T3; XTAL_ABM10W-40.0000MHZ-8-B1U-T3

Connections:
3V3: C75.1, C76.1, C77.1, C78.1, C79.1, C80.1, C81.1, C82.1, U9.2 (VDDA3P3), U9.3 (VDDA3P3), U9.5 (VDDPST1), U9.20 (VDDPST2), U9.29 (VDDA1), U9.32 (VDDA2); also elsewhere on the board
/ESP32/DEBUG_UART.RX: J5.1, U9.24 (SDIO_CLK)
/ESP32/DEBUG_UART.TX: J5.3, U9.23 (SDIO_CMD)
/ESP32/ESP32_GPIO.2: U9.8 (GPIO2); also elsewhere on the board
/ESP32/ESP32_GPIO.3: U9.9 (GPIO3); also elsewhere on the board
/ESP32/ESP32_GPIO.8: U9.14 (GPIO8); also elsewhere on the board
/ESP32/ESP32_GPIO.9: U9.15 (GPIO9); also elsewhere on the board
/ESP32/ESP32_UART.RX: J5.4, U9.22 (U0RXD); also elsewhere on the board
/ESP32/ESP32_UART.TX: J5.2, U9.21 (U0TXD); also elsewhere on the board
/ESP32/JTAG.MTCK: U9.12 (MTCK)
/ESP32/JTAG.MTDI: U9.11 (MTDI)
/ESP32/JTAG.MTDO: U9.13 (MTDO)
/ESP32/JTAG.MTMS: U9.10 (MTMS)
/ESP32/USB.DN: J4.A7 (Dn1), J4.B7 (Dn2), U9.16 (GPIO12)
/ESP32/USB.DP: J4.A6 (Dp1), J4.B6 (Dp2), U9.17 (GPIO13)
/ESP32/WIFI_ANT: C85.1, L5.2
/MCU/ESP32_EN: R52.1, U9.4 (CHIP_PU); also elsewhere on the board
GND: C75.2, C76.2, C77.2, C78.2, C79.2, C80.2, C81.2, C82.2, C83.2, C84.2, C85.2, C86.2, J4.A1 (GND), J4.B1 (GND), J4.SH1 (GND), J4.SH2 (GND), J4.SH3 (GND), J4.SH4 (GND), J5.5, R51.2, R52.2, R53.2, U9.33 (GND), Y1.2 (GND), Y1.4 (GND); also elsewhere on the board
unnamed: C83.1, R54.2, Y1.1
unnamed: C86.1, R63.2, Y1.3
unnamed: J4.A5 (CC1), R51.1
unnamed: J4.B5 (CC2), R53.1
unnamed: C84.1, L5.1, U9.1 (ANT)
unnamed: R63.1, U9.30 (XTAL_N)
unnamed: R54.1, U9.31 (XTAL_P)

Notes on the sheet:
TODO(cnr): JTAG / Debug header

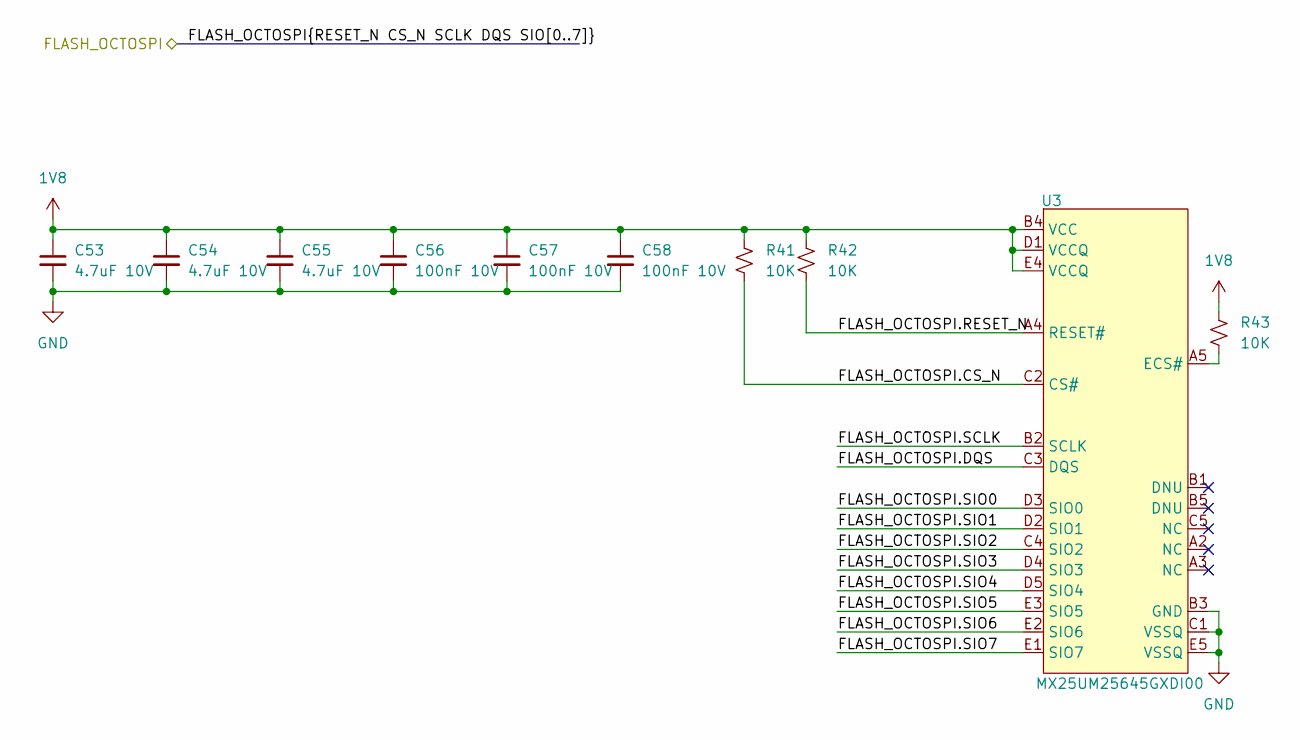
[picture p39: schematic flash.kicad_sch]

Parts:
C53, C54, C55: 4.7uF 10V; C_0402_1005Metric
C56, C57, C58: 100nF 10V; C_0402_1005Metric
R41, R42, R43: 10K; R_0402_1005Metric
U3: MX25UM25645GXDI00

Connections:
1V8: C53.1, C54.1, C55.1, C56.1, C57.1, C58.1, R41.1, R42.1, R43.1, U3.B4 (VCC), U3.D1 (VCCQ), U3.E4 (VCCQ); also elsewhere on the board
/Flash/FLASH_OCTOSPI.CS_N: R41.2, U3.C2 (CS#); also elsewhere on the board
/Flash/FLASH_OCTOSPI.DQS: U3.C3 (DQS); also elsewhere on the board
/Flash/FLASH_OCTOSPI.RESET_N: R42.2, U3.A4 (RESET#); also elsewhere on the board
/Flash/FLASH_OCTOSPI.SCLK: U3.B2 (SCLK); also elsewhere on the board
/Flash/FLASH_OCTOSPI.SIO0: U3.D3 (SIO0); also elsewhere on the board
/Flash/FLASH_OCTOSPI.SIO1: U3.D2 (SIO1); also elsewhere on the board
/Flash/FLASH_OCTOSPI.SIO2: U3.C4 (SIO2); also elsewhere on the board
/Flash/FLASH_OCTOSPI.SIO3: U3.D4 (SIO3); also elsewhere on the board
/Flash/FLASH_OCTOSPI.SIO4: U3.D5 (SIO4); also elsewhere on the board
/Flash/FLASH_OCTOSPI.SIO5: U3.E3 (SIO5); also elsewhere on the board
/Flash/FLASH_OCTOSPI.SIO6: U3.E2 (SIO6); also elsewhere on the board
/Flash/FLASH_OCTOSPI.SIO7: U3.E1 (SIO7); also elsewhere on the board
GND: C53.2, C54.2, C55.2, C56.2, C57.2, C58.2, U3.B3 (GND), U3.C1 (VSSQ), U3.E5 (VSSQ); also elsewhere on the board
unnamed: R43.2, U3.A5 (ECS#)
