enigmr/game-console-1/projects/main-board/main-board.kicad_pcb

## KiCad design projects/main-board/main-board.kicad_pcb (continued)

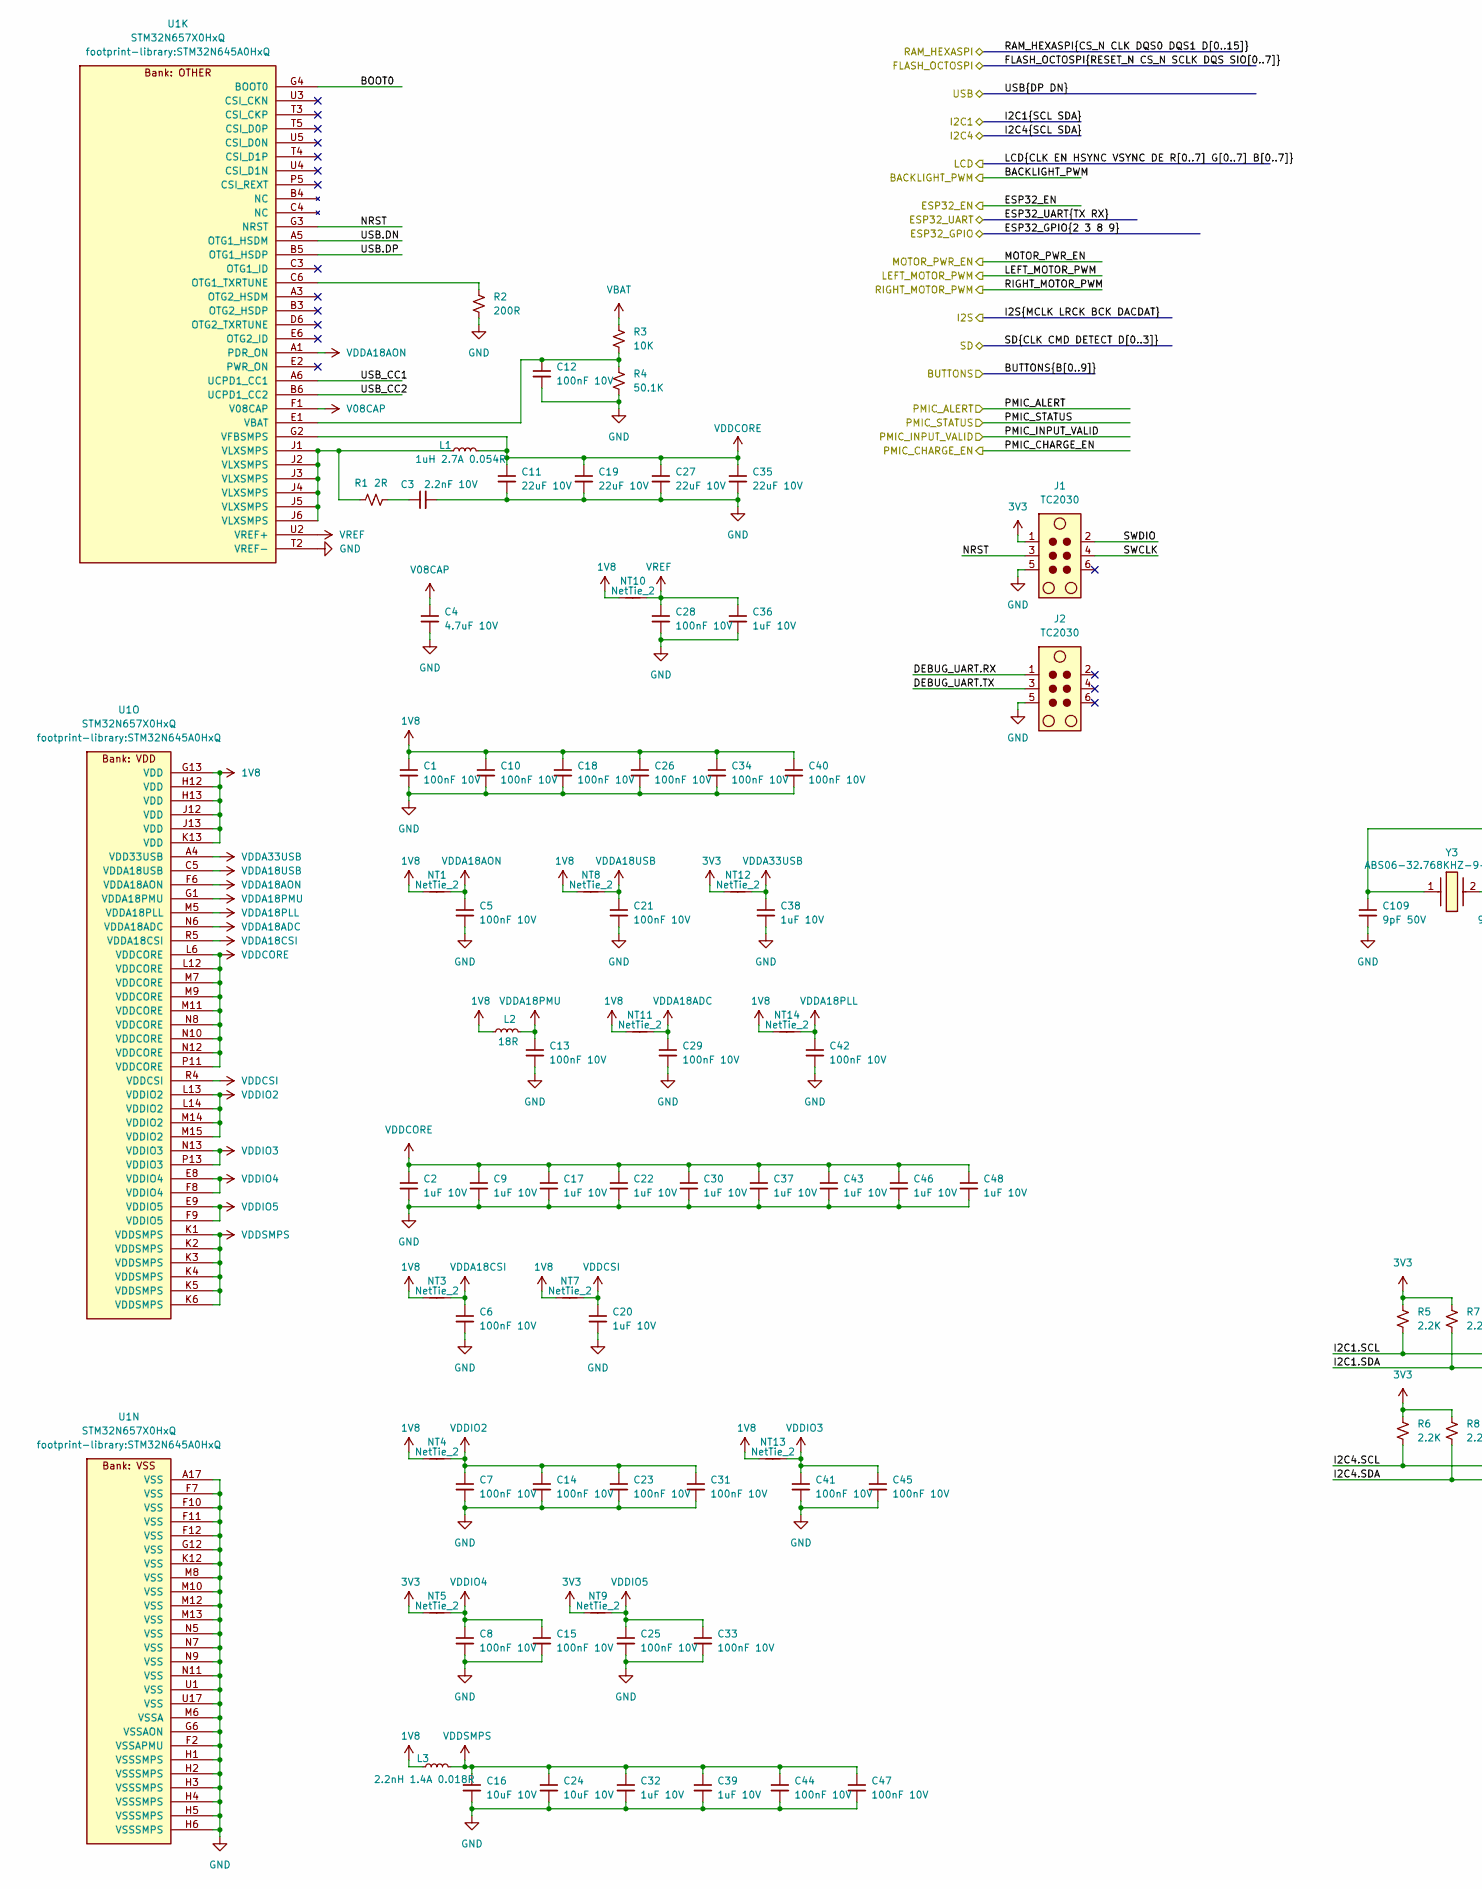
[picture p40: schematic mcu.kicad_sch, part in row 1, column 1]

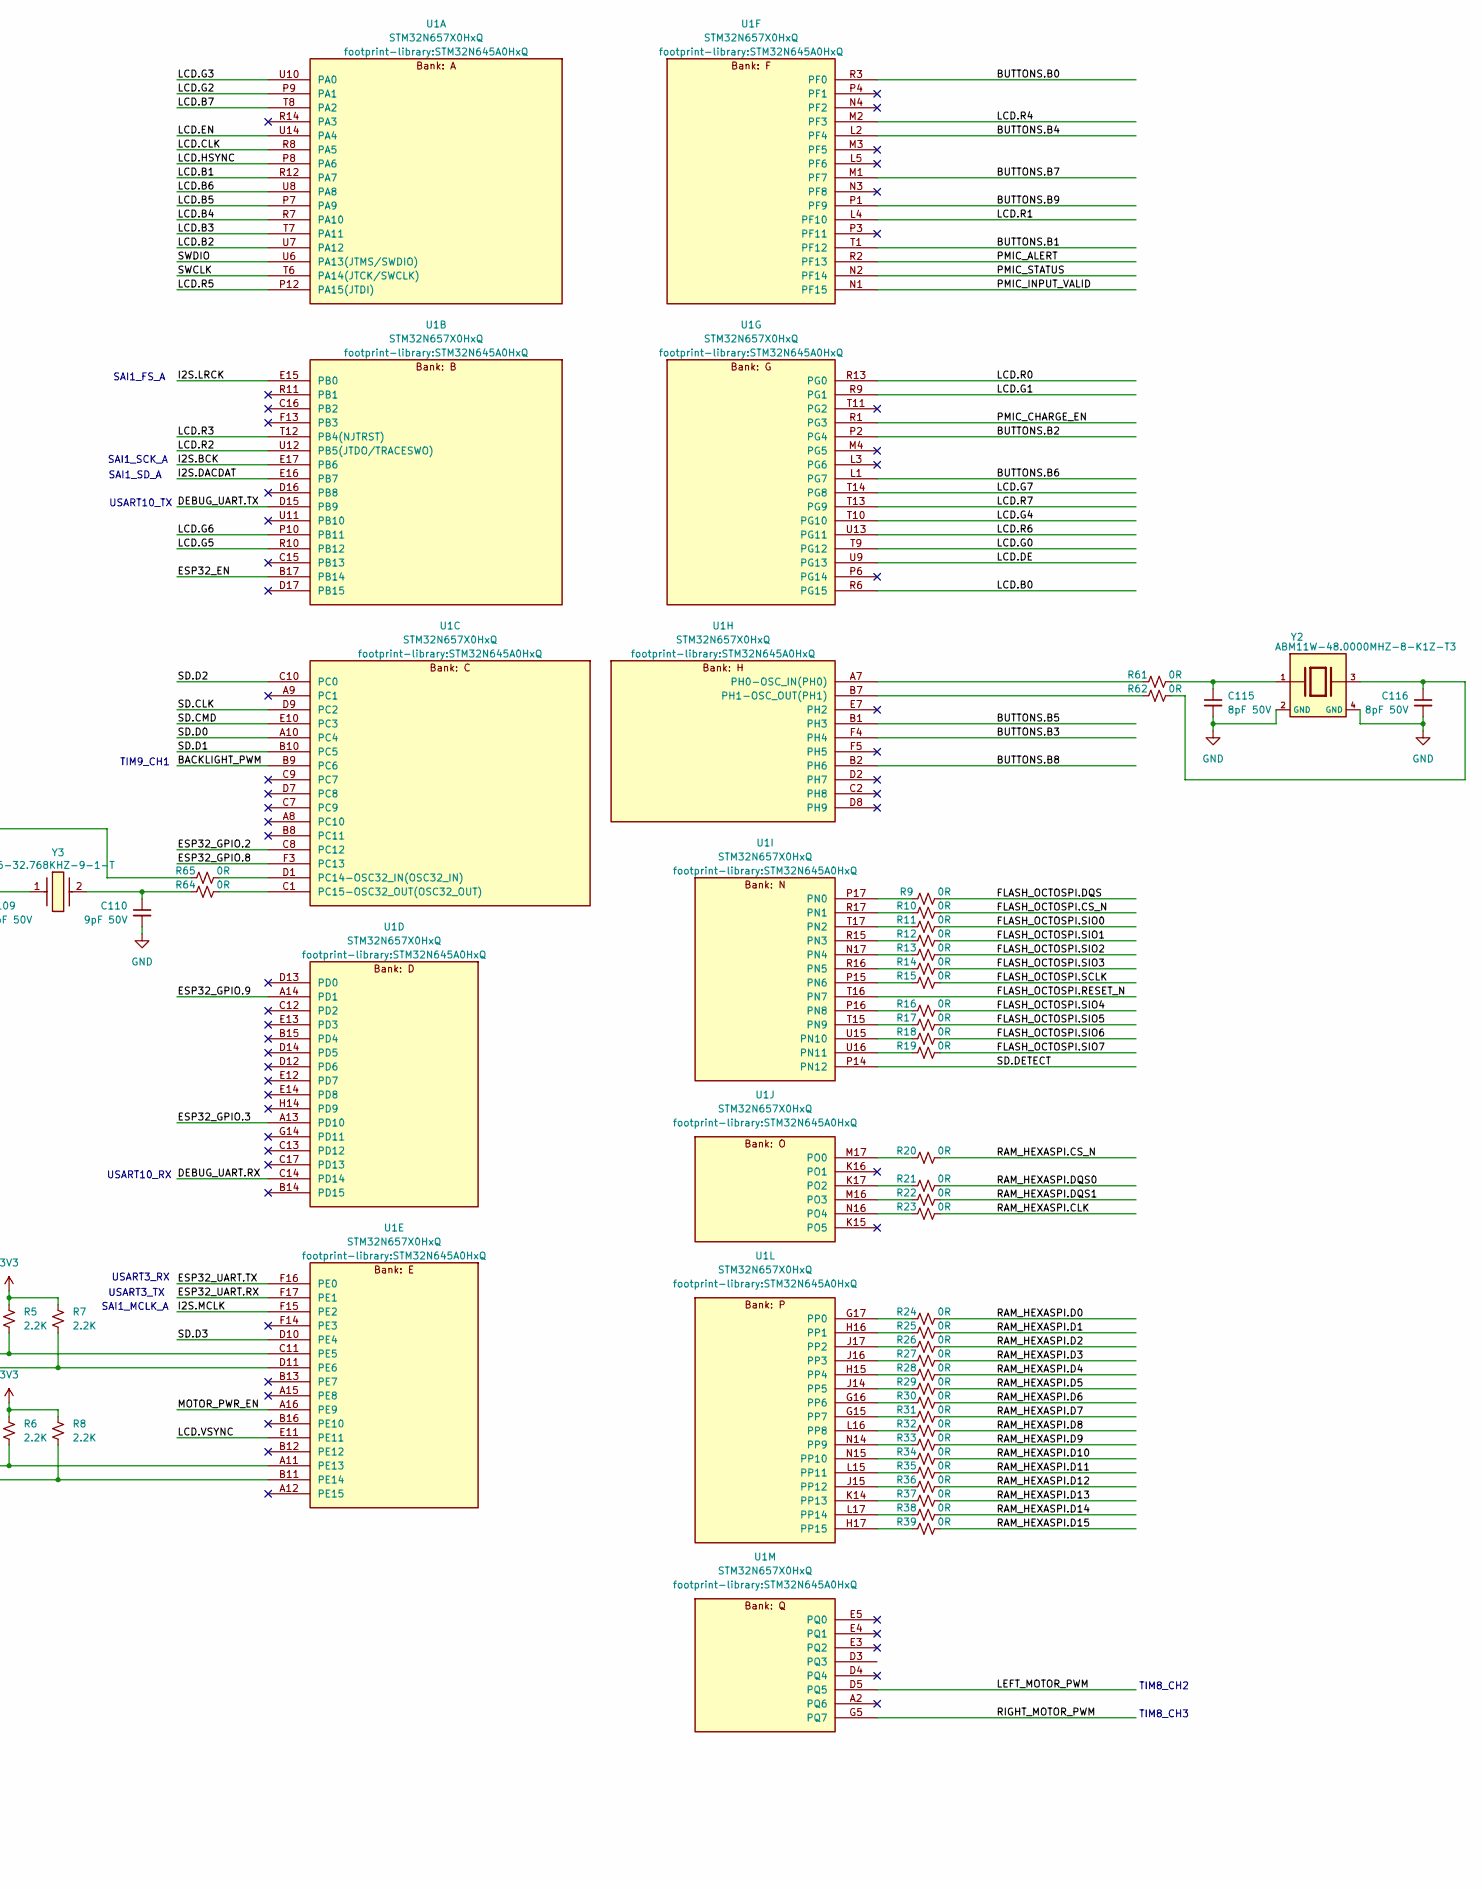
[picture p41: schematic mcu.kicad_sch, part in row 1, column 2]

Parts:
C1, C5, C6, C7, C8, C10, C12, C13, C14, C15, C18, C21, C23, C25, C26, C28, C29, C31, C33, C34, C40, C41, C42, C44, C45, C47: 100nF 10V; C_0402_1005Metric
C2, C9, C17, C20, C22, C30, C32, C36, C37, C38, C39, C43, C46, C48: 1uF 10V; C_0402_1005Metric
C3: 2.2nF 10V; C_0402_1005Metric
C4: 4.7uF 10V; C_0402_1005Metric
C11, C19, C27, C35: 22uF 10V; C_0603_1608Metric
C16, C24: 10uF 10V; C_0603_1608Metric
C109, C110: 9pF 50V; C_0402_1005Metric
C115, C116: 8pF 50V; C_0402_1005Metric
J1, J2: TC2030; Tag-Connect_TC2030-IDC-NL_2x03_P1.27mm_Vertical
L1: 1uH 2.7A 0.054R; IND_0806
L2: 18R; L_0603_1608Metric
L3: 2.2nH 1.4A 0.018R; L_0603_1608Metric
NT1, NT3, NT4, NT5, NT7, NT8, NT9, NT10, NT11, NT12, NT13, NT14: NetTie_2
R1: 2R; R_0402_1005Metric
R2: 200R; R_0402_1005Metric
R3: 10K; R_0402_1005Metric
R4: 50.1K; R_0402_1005Metric
R5, R6, R7, R8: 2.2K; R_0402_1005Metric
R9, R10, R11, R12, R13, R14, R15, R16, R17, R18, R19, R20, R21, R22, R23, R24, R25, R26, R27, R28, R29, R30, R31, R32, R33, R34, R35, R36, R37, R38, R39, R61, R62, R64, R65: 0R; R_0402_1005Metric
U1: STM32N657X0HxQ; STM32N645A0HxQ
Y2: ABM11W-48.0000MHZ-8-K1Z-T3; ABM11W300000MHZ4B1UT3; Manufacturer_Part_Number ABM11W-48.0000MHZ-8-K1Z-T3; Mouser Part Number 815-11W48-8K1ZT
Y3: ABS06-32.768KHZ-9-1-T; ABS06

Connections:
1V8: C1.1, C10.1, C18.1, C26.1, C34.1, C40.1, L2.1, L3.1, NT1.2, NT3.2, NT4.2, NT7.2, NT8.2, NT10.2, NT11.2, NT13.2, NT14.2, U1.G13 (VDD), U1.H12 (VDD), U1.H13 (VDD), U1.J12 (VDD), U1.J13 (VDD), U1.K13 (VDD); also elsewhere on the board
3V3: J1.1, NT5.2, NT9.2, NT12.2, R5.1, R6.1, R7.1, R8.1; also elsewhere on the board
/Audio/I2C.SCL: R5.2, U1.C11 (PE5); also elsewhere on the board
/Audio/I2C.SDA: R7.2, U1.D11 (PE6); also elsewhere on the board
/Audio/I2S.BCK: U1.E17 (PB6); also elsewhere on the board
/Audio/I2S.DACDAT: U1.E16 (PB7); also elsewhere on the board
/Audio/I2S.LRCK: U1.E15 (PB0); also elsewhere on the board
/Audio/I2S.MCLK: U1.F15 (PE2); also elsewhere on the board
/Controllers/BUTTONS.B0: U1.R3 (PF0); also elsewhere on the board
/Controllers/BUTTONS.B1: U1.T1 (PF12); also elsewhere on the board
/Controllers/BUTTONS.B2: U1.P2 (PG4); also elsewhere on the board
/Controllers/BUTTONS.B3: U1.F4 (PH4); also elsewhere on the board
/Controllers/BUTTONS.B4: U1.L2 (PF4); also elsewhere on the board
/Controllers/BUTTONS.B5: U1.B1 (PH3); also elsewhere on the board
/Controllers/BUTTONS.B6: U1.L1 (PG7); also elsewhere on the board
/Controllers/BUTTONS.B7: U1.M1 (PF7); also elsewhere on the board
/Controllers/BUTTONS.B8: U1.B2 (PH6); also elsewhere on the board
/Controllers/BUTTONS.B9: U1.P1 (PF9); also elsewhere on the board
/ESP32/ESP32_GPIO.2: U1.C8 (PC12); also elsewhere on the board
/ESP32/ESP32_GPIO.3: U1.A13 (PD10); also elsewhere on the board
/ESP32/ESP32_GPIO.8: U1.F3 (PC13); also elsewhere on the board
/ESP32/ESP32_GPIO.9: U1.A14 (PD1); also elsewhere on the board
/ESP32/ESP32_UART.RX: U1.F17 (PE1); also elsewhere on the board
/ESP32/ESP32_UART.TX: U1.F16 (PE0); also elsewhere on the board
/Flash/FLASH_OCTOSPI.CS_N: R10.2; also elsewhere on the board
/Flash/FLASH_OCTOSPI.DQS: R9.2; also elsewhere on the board
/Flash/FLASH_OCTOSPI.RESET_N: U1.T16 (PN7); also elsewhere on the board
/Flash/FLASH_OCTOSPI.SCLK: R15.2; also elsewhere on the board
/Flash/FLASH_OCTOSPI.SIO0: R11.2; also elsewhere on the board
/Flash/FLASH_OCTOSPI.SIO1: R12.2; also elsewhere on the board
/Flash/FLASH_OCTOSPI.SIO2: R13.2; also elsewhere on the board
/Flash/FLASH_OCTOSPI.SIO3: R14.2; also elsewhere on the board
/Flash/FLASH_OCTOSPI.SIO4: R16.2; also elsewhere on the board
/Flash/FLASH_OCTOSPI.SIO5: R17.2; also elsewhere on the board
/Flash/FLASH_OCTOSPI.SIO6: R18.2; also elsewhere on the board
/Flash/FLASH_OCTOSPI.SIO7: R19.2; also elsewhere on the board
/Haptics/LEFT_MOTOR_EN: U1.D5 (PQ5); also elsewhere on the board
/Haptics/MOTOR_PWR_EN: U1.A16 (PE9); also elsewhere on the board
/Haptics/RIGHT_MOTOR_EN: U1.G5 (PQ7); also elsewhere on the board
/LCD/BACKLIGHT_PWM: U1.B9 (PC6); also elsewhere on the board
/LCD/LCD.B0: U1.R6 (PG15); also elsewhere on the board
/LCD/LCD.B1: U1.R12 (PA7); also elsewhere on the board
/LCD/LCD.B2: U1.U7 (PA12); also elsewhere on the board
/LCD/LCD.B3: U1.T7 (PA11); also elsewhere on the board
/LCD/LCD.B4: U1.R7 (PA10); also elsewhere on the board
/LCD/LCD.B5: U1.P7 (PA9); also elsewhere on the board
/LCD/LCD.B6: U1.U8 (PA8); also elsewhere on the board
/LCD/LCD.B7: U1.T8 (PA2); also elsewhere on the board
/LCD/LCD.CLK: U1.R8 (PA5); also elsewhere on the board
/LCD/LCD.DE: U1.U9 (PG13); also elsewhere on the board
/LCD/LCD.EN: U1.U14 (PA4); also elsewhere on the board
/LCD/LCD.G0: U1.T9 (PG12); also elsewhere on the board
/LCD/LCD.G1: U1.R9 (PG1); also elsewhere on the board
/LCD/LCD.G2: U1.P9 (PA1); also elsewhere on the board
/LCD/LCD.G3: U1.U10 (PA0); also elsewhere on the board
/LCD/LCD.G4: U1.T10 (PG10); also elsewhere on the board
/LCD/LCD.G5: U1.R10 (PB12); also elsewhere on the board
/LCD/LCD.G6: U1.P10 (PB11); also elsewhere on the board
/LCD/LCD.G7: U1.T14 (PG8); also elsewhere on the board
/LCD/LCD.HSYNC: U1.P8 (PA6); also elsewhere on the board
/LCD/LCD.R0: U1.R13 (PG0); also elsewhere on the board
/LCD/LCD.R1: U1.L4 (PF10); also elsewhere on the board
/LCD/LCD.R2: U1.U12 (PB5(JTDO/TRACESWO)); also elsewhere on the board
/LCD/LCD.R3: U1.T12 (PB4(NJTRST)); also elsewhere on the board
/LCD/LCD.R4: U1.M2 (PF3); also elsewhere on the board
/LCD/LCD.R5: U1.P12 (PA15(JTDI)); also elsewhere on the board
/LCD/LCD.R6: U1.U13 (PG11); also elsewhere on the board
/LCD/LCD.R7: U1.T13 (PG9); also elsewhere on the board
/LCD/LCD.VSYNC: U1.E11; also elsewhere on the board
/MCU/BOOT0: U1.G4 (BOOT0)
/MCU/DEBUG_UART.RX: J2.1, U1.C14 (PD14)
/MCU/DEBUG_UART.TX: J2.3, U1.D15 (PB9)
/MCU/ESP32_EN: U1.B17 (PB14); also elsewhere on the board
/MCU/I2C4.SCL: R6.2, U1.A11 (PE13); also elsewhere on the board
/MCU/I2C4.SDA: R8.2, U1.B11 (PE14); also elsewhere on the board
/MCU/NRST: J1.3, U1.G3 (NRST)
/MCU/PMIC_ALERT: U1.R2 (PF13); also elsewhere on the board
/MCU/PMIC_CHARGE_EN: U1.R1 (PG3); also elsewhere on the board
/MCU/PMIC_INPUT_VALID: U1.N1 (PF15); also elsewhere on the board
/MCU/PMIC_STATUS: U1.N2 (PF14); also elsewhere on the board
/MCU/RAM_HEXASPI.CLK: R23.2; also elsewhere on the board
/MCU/RAM_HEXASPI.CS_N: R20.2; also elsewhere on the board
/MCU/RAM_HEXASPI.D0: R24.2; also elsewhere on the board
/MCU/RAM_HEXASPI.D1: R25.2; also elsewhere on the board
/MCU/RAM_HEXASPI.D2: R26.2; also elsewhere on the board
/MCU/RAM_HEXASPI.D3: R27.2; also elsewhere on the board
/MCU/RAM_HEXASPI.D4: R28.2; also elsewhere on the board
/MCU/RAM_HEXASPI.D5: R29.2; also elsewhere on the board
/MCU/RAM_HEXASPI.D6: R30.2; also elsewhere on the board
/MCU/RAM_HEXASPI.D7: R31.2; also elsewhere on the board
/MCU/RAM_HEXASPI.D8: R32.2; also elsewhere on the board
/MCU/RAM_HEXASPI.D9: R33.2; also elsewhere on the board
/MCU/RAM_HEXASPI.D10: R34.2; also elsewhere on the board
/MCU/RAM_HEXASPI.D11: R35.2; also elsewhere on the board
/MCU/RAM_HEXASPI.D12: R36.2; also elsewhere on the board
/MCU/RAM_HEXASPI.D13: R37.2; also elsewhere on the board
/MCU/RAM_HEXASPI.D14: R38.2; also elsewhere on the board
/MCU/RAM_HEXASPI.D15: R39.2; also elsewhere on the board
/MCU/RAM_HEXASPI.DQS0: R21.2; also elsewhere on the board
/MCU/RAM_HEXASPI.DQS1: R22.2; also elsewhere on the board
/MCU/SD.CLK: U1.D9 (PC2); also elsewhere on the board
/MCU/SD.CMD: U1.E10 (PC3); also elsewhere on the board
/MCU/SD.D0: U1.A10 (PC4); also elsewhere on the board
/MCU/SD.D1: U1.B10 (PC5); also elsewhere on the board
/MCU/SD.D2: U1.C10 (PC0); also elsewhere on the board
/MCU/SD.D3: U1.D10 (PE4); also elsewhere on the board
/MCU/SD.DETECT: U1.P14 (PN12)
/MCU/SWCLK: J1.4, U1.T6 (PA14(JTCK/SWCLK))
/MCU/SWDIO: J1.2, U1.U6 (PA13(JTMS/SWDIO))
/MCU/USB.DN: U1.A5 (OTG1_HSDM); also elsewhere on the board
/MCU/USB.DP: U1.B5 (OTG1_HSDP); also elsewhere on the board
/MCU/USB_CC1: U1.A6 (UCPD1_CC1)
/MCU/USB_CC2: U1.B6 (UCPD1_CC2)
GND: C1.2, C2.2, C3.2, C4.2, C5.2, C6.2, C7.2, C8.2, C9.2, C10.2, C11.2, C12.2, C13.2, C14.2, C15.2, C16.2, C17.2, C18.2, C19.2, C20.2, C21.2, C22.2, C23.2, C24.2, C25.2, C26.2, C27.2, C28.2, C29.2, C30.2, C31.2, C32.2, C33.2, C34.2, C35.2, C36.2, C37.2, C38.2, C39.2, C40.2, C41.2, C42.2, C43.2, C44.2, C45.2, C46.2, C47.2, C48.2, C109.2, C110.2, C115.2, C116.2, J1.5, J2.5, R2.2, R4.2, U1.A17 (VSS), U1.F2 (VSSAPMU), U1.F7 (VSS), U1.F10 (VSS), U1.F11 (VSS), U1.F12 (VSS), U1.G6 (VSSAON), U1.G12 (VSS), U1.H1 (VSSSMPS), U1.H2 (VSSSMPS), U1.H3 (VSSSMPS), U1.H4 (VSSSMPS), U1.H5 (VSSSMPS), U1.H6 (VSSSMPS), U1.K12 (VSS), U1.M6 (VSSA), U1.M8 (VSS), U1.M10 (VSS), U1.M12 (VSS), U1.M13 (VSS), U1.N5 (VSS), U1.N7 (VSS), U1.N9 (VSS), U1.N11 (VSS), U1.T2 (VREF-), U1.U1 (VSS), U1.U17 (VSS), Y2.2 (GND), Y2.4 (GND); also elsewhere on the board
unnamed: C3.1, R1.2
unnamed: C109.1, R65.1, Y3.1
unnamed: C110.1, R64.1, Y3.2
unnamed: C115.1, R61.2, Y2.1
unnamed: C116.1, R62.2, Y2.3
unnamed: L1.1, R1.1, U1.J1 (VLXSMPS), U1.J2 (VLXSMPS), U1.J3 (VLXSMPS), U1.J4 (VLXSMPS), U1.J5 (VLXSMPS), U1.J6 (VLXSMPS)
unnamed: R65.2, U1.D1 (PC14-OSC32_IN(OSC32_IN))
unnamed: R64.2, U1.C1 (PC15-OSC32_OUT(OSC32_OUT))
unnamed: R61.1, U1.A7 (PH0-OSC_IN(PH0))
unnamed: R62.1, U1.B7 (PH1-OSC_OUT(PH1))
unnamed: R9.1, U1.P17 (PN0)
unnamed: R10.1, U1.R17 (PN1)
unnamed: R11.1, U1.T17 (PN2)
unnamed: R12.1, U1.R15 (PN3)
unnamed: R13.1, U1.N17 (PN4)
unnamed: R14.1, U1.R16 (PN5)
unnamed: R15.1, U1.P15 (PN6)
unnamed: R16.1, U1.P16 (PN8)
unnamed: R17.1, U1.T15 (PN9)
unnamed: R18.1, U1.U15 (PN10)
unnamed: R19.1, U1.U16 (PN11)
unnamed: R20.1, U1.M17 (PO0)
unnamed: R21.1, U1.K17 (PO2)
unnamed: R22.1, U1.M16 (PO3)
unnamed: R23.1, U1.N16 (PO4)
unnamed: R2.1, U1.C6 (OTG1_TXRTUNE)
unnamed: C12.1, R3.2, R4.1, U1.E1 (VBAT)
unnamed: R24.1, U1.G17 (PP0)
unnamed: R25.1, U1.H16 (PP1)
unnamed: R26.1, U1.J17 (PP2)
unnamed: R27.1, U1.J16 (PP3)
unnamed: R28.1, U1.H15 (PP4)
unnamed: R29.1, U1.J14 (PP5)
unnamed: R30.1, U1.G16 (PP6)
unnamed: R31.1, U1.G15 (PP7)
unnamed: R32.1, U1.L16 (PP8)
unnamed: R33.1, U1.N14 (PP9)
unnamed: R34.1, U1.N15 (PP10)
unnamed: R35.1, U1.L15 (PP11)
unnamed: R36.1, U1.J15 (PP12)
unnamed: R37.1, U1.K14 (PP13)
unnamed: R38.1, U1.L17 (PP14)
unnamed: R39.1, U1.H17 (PP15)
V08CAP: C4.1, U1.F1 (V08CAP)
VBAT: R3.1; also elsewhere on the board
VDDA18ADC: C29.1, NT11.1, U1.N6 (VDDA18ADC)
VDDA18AON: C5.1, NT1.1, U1.A1 (PDR_ON), U1.F6 (VDDA18AON)
VDDA18CSI: C6.1, NT3.1, U1.R5 (VDDA18CSI)
VDDA18PLL: C42.1, NT14.1, U1.M5 (VDDA18PLL)
VDDA18PMU: C13.1, L2.2, U1.G1 (VDDA18PMU)
VDDA18USB: C21.1, NT8.1, U1.C5 (VDDA18USB)
VDDA33USB: C38.1, NT12.1, U1.A4 (VDD33USB)
VDDCORE: C2.1, C9.1, C11.1, C17.1, C19.1, C22.1, C27.1, C30.1, C35.1, C37.1, C43.1, C46.1, C48.1, L1.2, U1.G2 (VFBSMPS), U1.L6 (VDDCORE), U1.L12 (VDDCORE), U1.M7 (VDDCORE), U1.M9 (VDDCORE), U1.M11 (VDDCORE), U1.N8 (VDDCORE), U1.N10 (VDDCORE), U1.N12 (VDDCORE), U1.P11 (VDDCORE)
VDDCSI: C20.1, NT7.1, U1.R4 (VDDCSI)
VDDIO2: C7.1, C14.1, C23.1, C31.1, NT4.1, U1.L13 (VDDIO2), U1.L14 (VDDIO2), U1.M14 (VDDIO2), U1.M15 (VDDIO2)
VDDIO3: C41.1, C45.1, NT13.1, U1.N13 (VDDIO3), U1.P13 (VDDIO3)
VDDIO4: C8.1, C15.1, NT5.1, U1.E8 (VDDIO4), U1.F8 (VDDIO4)
VDDIO5: C25.1, C33.1, NT9.1, U1.E9 (VDDIO5), U1.F9 (VDDIO5)
VDDSMPS: C16.1, C24.1, C32.1, C39.1, C44.1, C47.1, L3.2, U1.K1 (VDDSMPS), U1.K2 (VDDSMPS), U1.K3 (VDDSMPS), U1.K4 (VDDSMPS), U1.K5 (VDDSMPS), U1.K6 (VDDSMPS)
VREF: C28.1, C36.1, NT10.1, U1.U2 (VREF+)

Notes on the sheet:
USART10_RX
SAI1_MCLK_A
USART3_RX
USART3_TX
USART10_TX
TIM8_CH3
TIM8_CH2
SAI1_SD_A
SAI1_SCK_A
TIM9_CH1
SAI1_FS_A

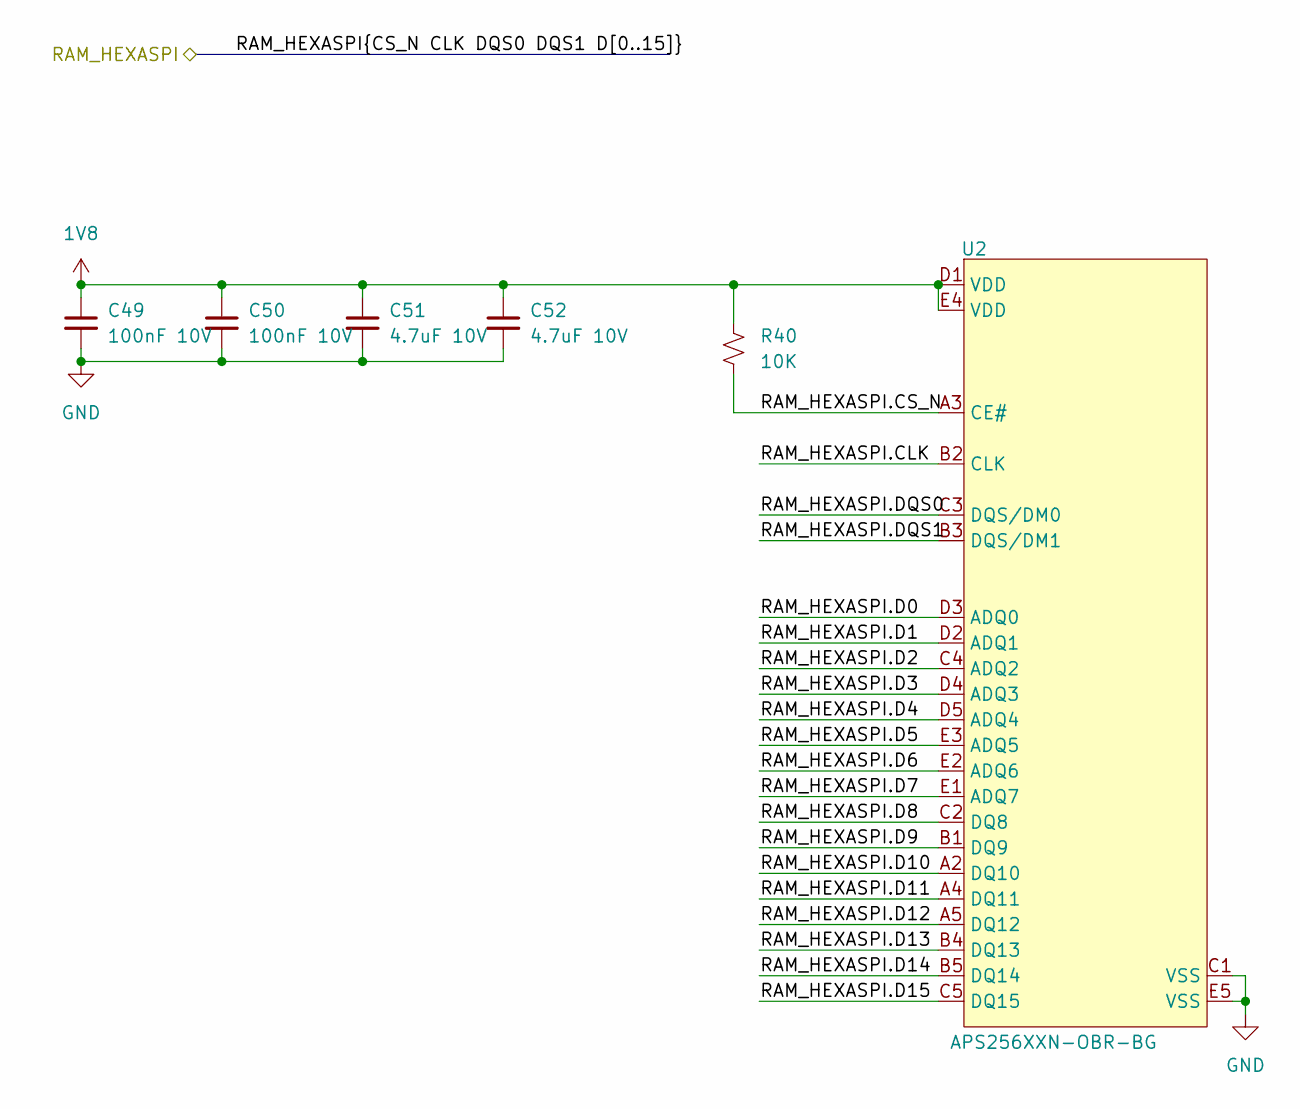
[picture p42: schematic ram.kicad_sch]

Parts:
C49, C50: 100nF 10V; C_0402_1005Metric
C51, C52: 4.7uF 10V; C_0402_1005Metric
R40: 10K; R_0402_1005Metric
U2: APS256XXN-OBR-BG

Connections:
1V8: C49.1, C50.1, C51.1, C52.1, R40.1, U2.D1 (VDD), U2.E4 (VDD); also elsewhere on the board
/MCU/RAM_HEXASPI.CLK: U2.B2 (CLK); also elsewhere on the board
/MCU/RAM_HEXASPI.CS_N: R40.2, U2.A3 (CE#); also elsewhere on the board
/MCU/RAM_HEXASPI.D0: U2.D3 (ADQ0); also elsewhere on the board
/MCU/RAM_HEXASPI.D1: U2.D2 (ADQ1); also elsewhere on the board
/MCU/RAM_HEXASPI.D2: U2.C4 (ADQ2); also elsewhere on the board
/MCU/RAM_HEXASPI.D3: U2.D4 (ADQ3); also elsewhere on the board
/MCU/RAM_HEXASPI.D4: U2.D5 (ADQ4); also elsewhere on the board
/MCU/RAM_HEXASPI.D5: U2.E3 (ADQ5); also elsewhere on the board
/MCU/RAM_HEXASPI.D6: U2.E2 (ADQ6); also elsewhere on the board
/MCU/RAM_HEXASPI.D7: U2.E1 (ADQ7); also elsewhere on the board
/MCU/RAM_HEXASPI.D8: U2.C2 (DQ8); also elsewhere on the board
/MCU/RAM_HEXASPI.D9: U2.B1 (DQ9); also elsewhere on the board
/MCU/RAM_HEXASPI.D10: U2.A2 (DQ10); also elsewhere on the board
/MCU/RAM_HEXASPI.D11: U2.A4 (DQ11); also elsewhere on the board
/MCU/RAM_HEXASPI.D12: U2.A5 (DQ12); also elsewhere on the board
/MCU/RAM_HEXASPI.D13: U2.B4 (DQ13); also elsewhere on the board
/MCU/RAM_HEXASPI.D14: U2.B5 (DQ14); also elsewhere on the board
/MCU/RAM_HEXASPI.D15: U2.C5 (DQ15); also elsewhere on the board
/MCU/RAM_HEXASPI.DQS0: U2.C3 (DQS/DM0); also elsewhere on the board
/MCU/RAM_HEXASPI.DQS1: U2.B3 (DQS/DM1); also elsewhere on the board
GND: C49.2, C50.2, C51.2, C52.2, U2.C1 (VSS), U2.E5 (VSS); also elsewhere on the board

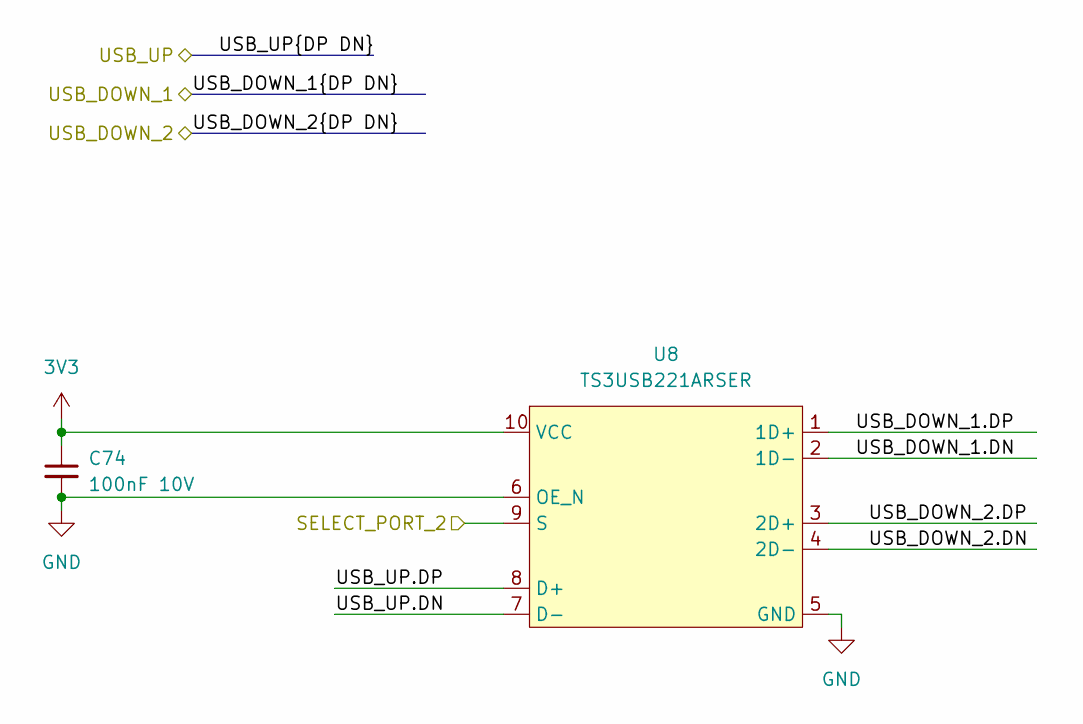
[picture p43: schematic usb-switch.kicad_sch]

Parts:
C74: 100nF 10V; C_0402_1005Metric
U8: TS3USB221ARSER

Connections:
3V3: C74.1, U8.10 (VCC); also elsewhere on the board
/MCU/USB.DN: U8.2 (1D-); also elsewhere on the board
/MCU/USB.DP: U8.1 (1D+); also elsewhere on the board
/Power/DATAMUX: U8.9 (S); also elsewhere on the board
/Power/USB.DN: U8.4 (2D-); also elsewhere on the board
/Power/USB.DP: U8.3 (2D+); also elsewhere on the board
/USB Switch/USB_UP.DN: U8.7 (D-); also elsewhere on the board
/USB Switch/USB_UP.DP: U8.8 (D+); also elsewhere on the board
GND: C74.2, U8.5 (GND), U8.6 (OE_N); also elsewhere on the board

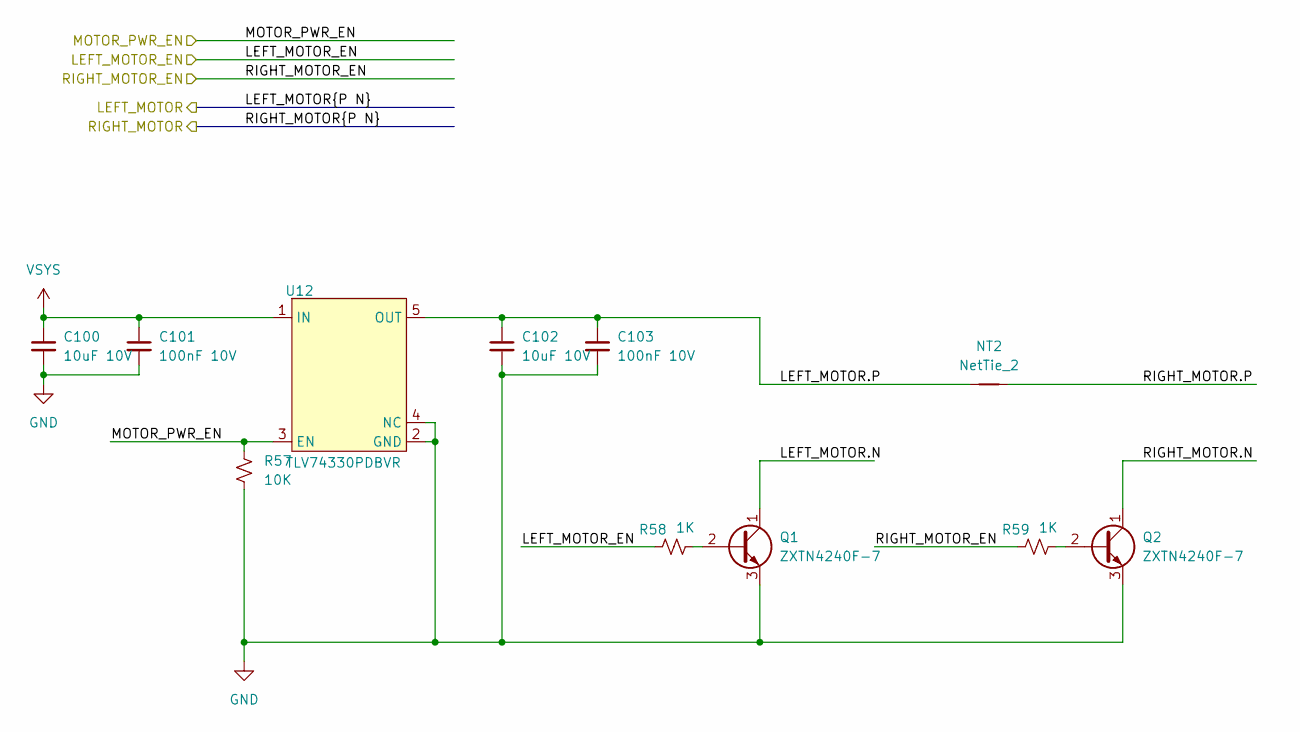
[picture p44: schematic haptics.kicad_sch]

Parts:
C100, C102: 10uF 10V; C_0603_1608Metric
C101, C103: 100nF 10V; C_0402_1005Metric
NT2: NetTie_2
Q1, Q2: ZXTN4240F-7; SOT23_ZXTN_DIO
R57: 10K; R_0402_1005Metric
R58, R59: 1K; R_0402_1005Metric
U12: TLV74330PDBVR

Connections:
/Controllers/LEFT_MOTOR.N: Q1.1 (C); also elsewhere on the board
/Controllers/LEFT_MOTOR.P: C102.1, C103.1, NT2.1, U12.5 (OUT); also elsewhere on the board
/Controllers/RIGHT_MOTOR.N: Q2.1 (C); also elsewhere on the board
/Haptics/LEFT_MOTOR_EN: R58.1; also elsewhere on the board
/Haptics/MOTOR_PWR_EN: R57.1, U12.3 (EN); also elsewhere on the board
/Haptics/RIGHT_MOTOR_EN: R59.1; also elsewhere on the board
GND: C100.2, C101.2, C102.2, C103.2, Q1.3 (E), Q2.3 (E), R57.2, U12.2 (GND), U12.4 (NC); also elsewhere on the board
unnamed: Q1.2 (B), R58.2
unnamed: Q2.2 (B), R59.2
VSYS: C100.1, C101.1, U12.1 (IN); also elsewhere on the board

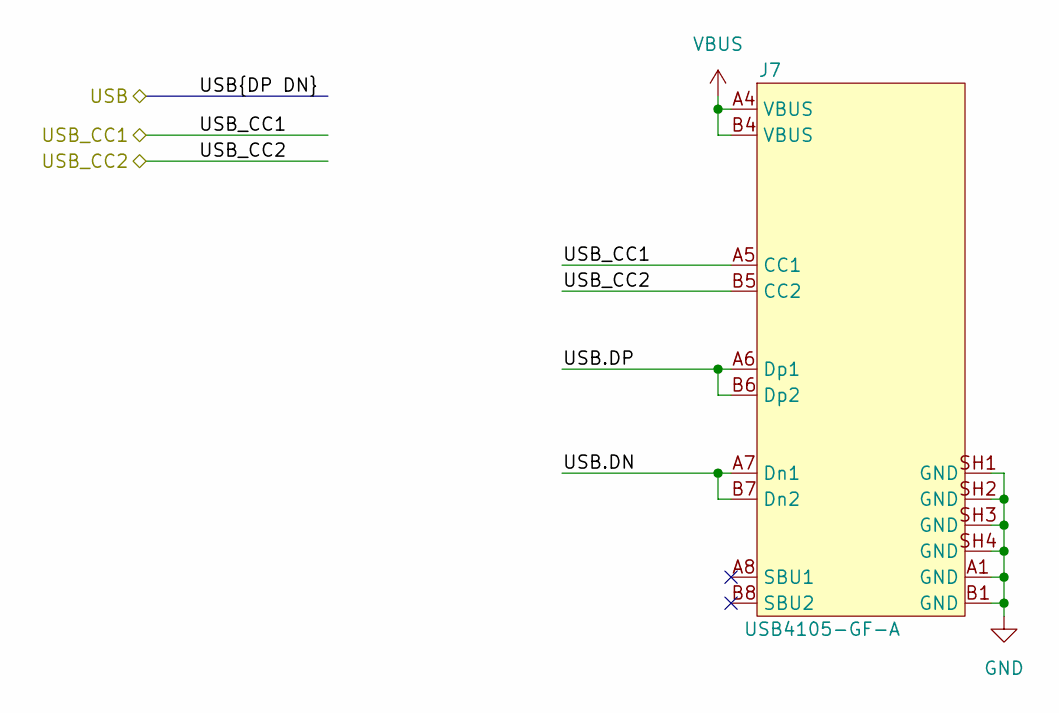
[picture p45: schematic usb.kicad_sch]

Parts:
J7: USB4105-GF-A

Connections:
/USB Switch/USB_UP.DN: J7.A7 (Dn1), J7.B7 (Dn2); also elsewhere on the board
/USB Switch/USB_UP.DP: J7.A6 (Dp1), J7.B6 (Dp2); also elsewhere on the board
/USB/USB_CC1: J7.A5 (CC1); also elsewhere on the board
/USB/USB_CC2: J7.B5 (CC2); also elsewhere on the board
GND: J7.A1 (GND), J7.B1 (GND), J7.SH1 (GND), J7.SH2 (GND), J7.SH3 (GND), J7.SH4 (GND); also elsewhere on the board
VBUS: J7.A4 (VBUS), J7.B4 (VBUS); also elsewhere on the board

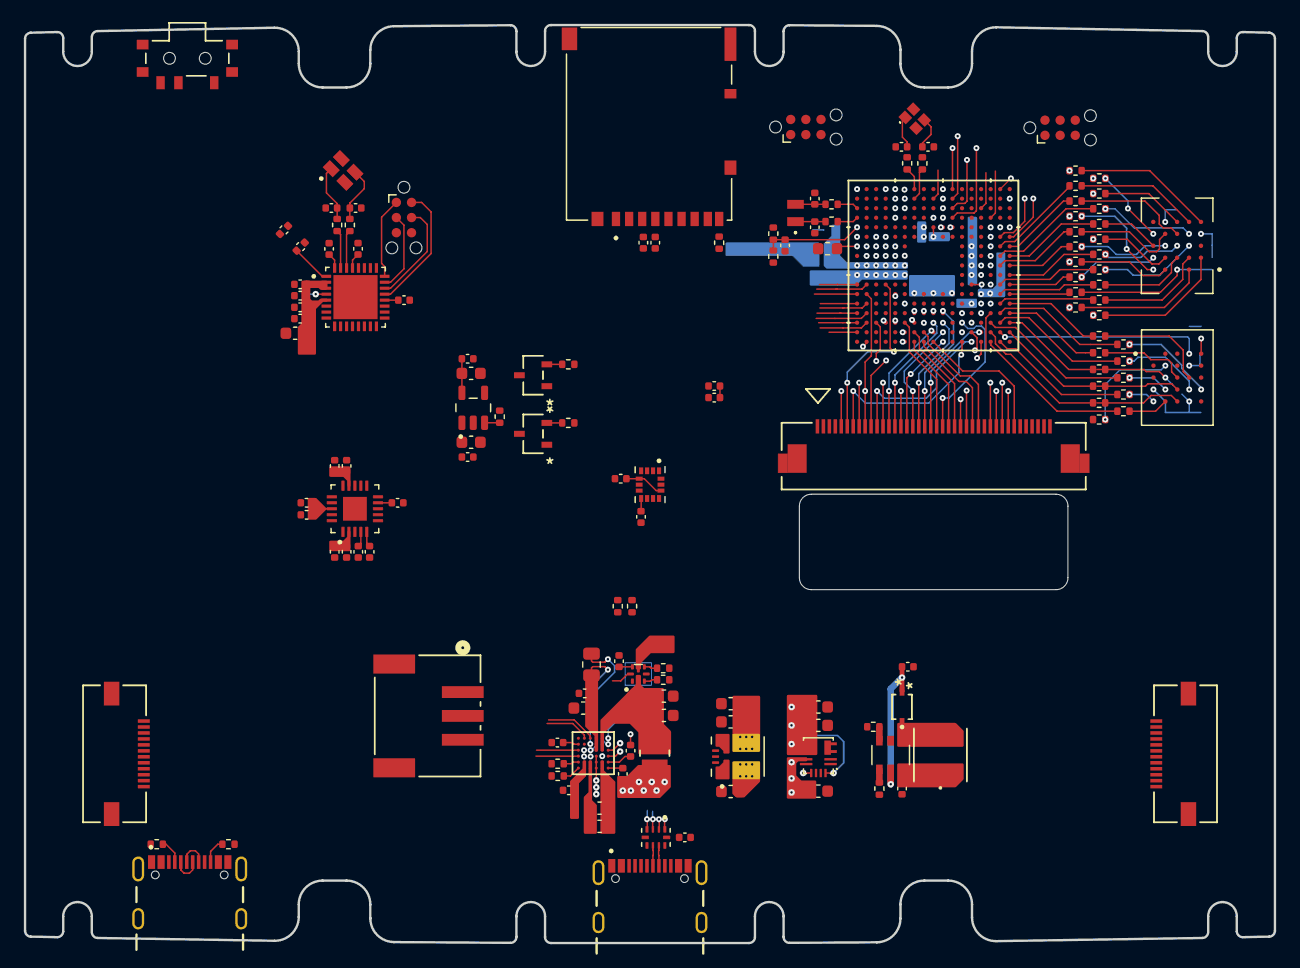
[picture p46: board main-board.kicad_pcb from above]

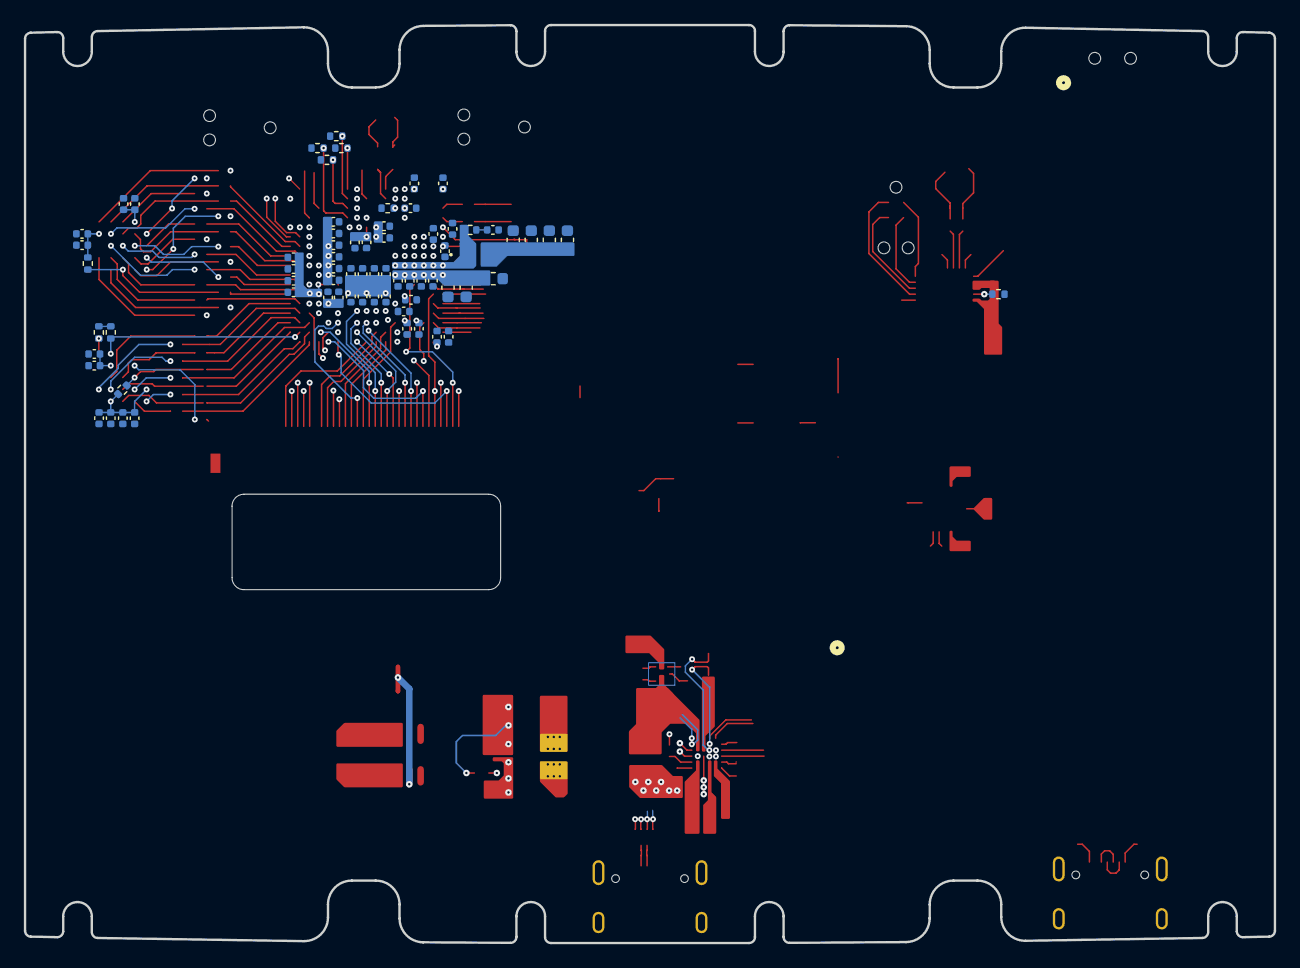
[picture p47: board main-board.kicad_pcb from below]

Board: 6 copper layers, 104.8 x 77.0 mm, 213 parts (70 on the bottom side), 219 nets.
