enigmr/game-console-1/projects/right-board/right-board.kicad_pcb

## KiCad design projects/right-board/right-board.kicad_pcb (2025-08-24)

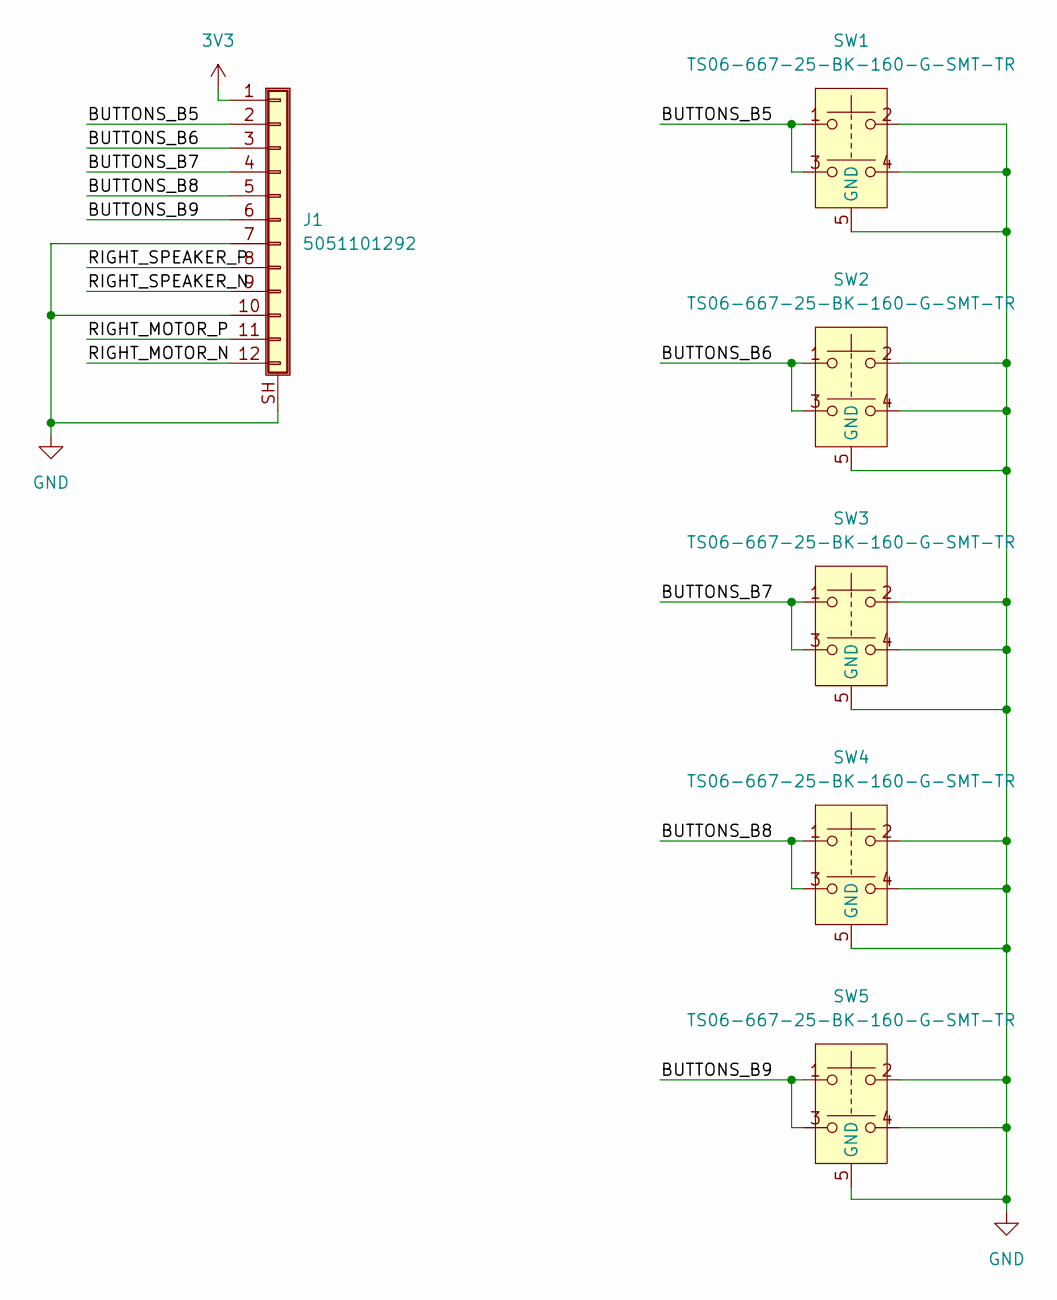
[picture p48: schematic right-board.kicad_sch]

Parts:
J1: 5051101292
SW1, SW2, SW3, SW4, SW5: TS06-667-25-BK-160-G-SMT-TR

Connections:
3V3: J1.1
/BUTTONS_B5: J1.2, SW1.1, SW1.3
/BUTTONS_B6: J1.3, SW2.1, SW2.3
/BUTTONS_B7: J1.4, SW3.1, SW3.3
/BUTTONS_B8: J1.5, SW4.1, SW4.3
/BUTTONS_B9: J1.6, SW5.1, SW5.3
/RIGHT_MOTOR_N: J1.12
/RIGHT_MOTOR_P: J1.11
/RIGHT_SPEAKER_N: J1.9
/RIGHT_SPEAKER_P: J1.8
GND: J1.7, J1.10, J1.SH (Shield), SW1.2, SW1.4, SW1.5 (GND), SW2.2, SW2.4, SW2.5 (GND), SW3.2, SW3.4, SW3.5 (GND), SW4.2, SW4.4, SW4.5 (GND), SW5.2, SW5.4, SW5.5 (GND)

Board: 2 copper layers, 6 parts (5 on the bottom side), 6 nets, no tracks yet.
