enigmr/game-console-1/(commit log)

2025-07-26 Add footprints and 3D models
    [541044031.stp, ABM10W-40.0000MHZ-8-B1U-T3--3DModel-STEP-400430.STEP, AP5725WG-7.STEP, APS256XXN-OBR-BG--3DModel-STEP-269445.STEP, ESP32-C6FH4--3DModel-STEP-56544.STEP, LSM6DSO32TR--3DModel-STEP-269445.STEP, MAX77972EWX+T.step, MPM3805GQB-18-Z v1.step]
2025-07-26 Updated schematics with new symbols
    [STM32N645A0HxQ.step, audio.kicad_sch, esp32.kicad_sch, flash.kicad_sch, haptics.kicad_sch, imu.kicad_sch, lcd.kicad_sch, mcu.kicad_sch]
2025-07-26 Re-annotate schematics.
    [audio.kicad_sch, buttons.kicad_sch, esp32.kicad_sch, flash.kicad_sch, haptics.kicad_sch, imu.kicad_sch, lcd.kicad_sch, main-board.kicad_pcb]
2025-07-26 Replace 0.1in header with TC2030
    [debug-headers.kicad_sch, esp32.kicad_sch, mcu.kicad_sch]
2025-07-26 Update schematic SVGs
2025-07-26 Add capacitor part library.
    [esp32.kicad_sch, flash.kicad_sch, lcd.kicad_sch, mcu.kicad_sch, pmic.kicad_sch, ram.kicad_sch]
2025-07-26 Normalise capacitors
    - Add capacitor parts to library.
    - Replace all placeholder capacitors
    with the actual part numbers.
    [audio.kicad_sch, buttons.kicad_sch, esp32.kicad_sch, flash.kicad_sch, haptics.kicad_sch, imu.kicad_sch, lcd.kicad_sch, mcu.kicad_sch]
2025-07-26 Add resistor library
2025-07-26 Replace placeholder resistors
    [esp32.kicad_sch, flash.kicad_sch, haptics.kicad_sch, lcd.kicad_sch, mcu.kicad_sch, micro-sd.kicad_sch, pmic.kicad_sch, ram.kicad_sch]
2025-07-27 Add footprints
    - Inductors
    - Switches
    - Buttons
    [Download_STP_450404015514_rev1.stp, IND_0806.step, IND_HMLQ25201T_CYN.step, IND_TAIYO_NR4012_TAY.step, S3B-PH-SM4-TB_LF__SN_.stp, SOD323_DIO.step, SOT23_ZXTN_DIO.step, Same_Sky_TS06-667-25-BK-160-G-SMT-TR.step]
2025-07-27 Add board design rules
    [main-board.kicad_pcb]
2025-07-27 Fix footprint DRC errors.
    [buttons.kicad_sch, esp32.kicad_sch, haptics.kicad_sch, imu.kicad_sch, lcd.kicad_sch, main-board.kicad_pcb, micro-sd.kicad_sch, pmic.kicad_sch]
2025-07-27 Rough PCB component grouping and layout
    [flash.kicad_sch, lcd.kicad_sch, main-board.kicad_pcb, main-board.kicad_sch, pmic.kicad_sch]
2025-07-27 Update renders.
    [main-board.kicad_pcb]
2025-07-27 Update images. Add render.
    [main-board.kicad_pcb]
2025-07-27 Update render.
    [buttons.kicad_sch, main-board.kicad_pcb, mcu.kicad_sch]
2025-07-29 Update render
    [buttons.kicad_sch, main-board.kicad_pcb, mcu.kicad_sch]
2025-07-30 Update PCB profile and render
    [main-board.kicad_pcb]
2025-08-03 Main board PCB layout and routing
    - Add 48MHz crystal for STM32
    - Add 32kHz crystal for STM32
    - Started laying out and routing board
    [ABM11W-48.0000MHZ-8-K1Z-T3.stp, ABS06-32.768KHZ-9-1-T.stp, esp32.kicad_sch, haptics.kicad_sch, main-board.kicad_pcb, main-board.kicad_sch, mcu.kicad_sch, pmic.kicad_sch]
2025-08-04 PCB layout and renders
    [flash.kicad_sch, main-board.kicad_pcb, mcu.kicad_sch, ram.kicad_sch]
2025-08-19 Routed LCD signals
    [main-board.kicad_pcb, mcu.kicad_sch]
2025-08-20 More routing of main board
    [main-board.kicad_pcb, mcu.kicad_sch]
2025-08-24 WIP splitting main board into 3
    [5051101292.stp, audio.kicad_sch, buttons.kicad_sch, controllers.kicad_sch, esp32.kicad_sch, flash.kicad_sch, haptics.kicad_sch, imu.kicad_sch]
2025-08-24 Reorganise repo to support multiple PCBs
    [5051101292.stp, 541044031.stp, ABM10W-40.0000MHZ-8-B1U-T3--3DModel-STEP-400430.STEP, ABM11W-48.0000MHZ-8-K1Z-T3.stp, ABS06-32.768KHZ-9-1-T.stp, AP5725WG-7.STEP, APS256XXN-OBR-BG--3DModel-STEP-269445.STEP, Download_STP_450404015514_rev1.stp]
2025-08-24 Add left board
    [left-board.kicad_pcb, left-board.kicad_sch]
2025-08-24 Add right board
    [right-board.kicad_pcb, right-board.kicad_sch]
2025-08-24 Fix wrong net name on left audio
    [controllers.kicad_sch, left-board.kicad_pcb, left-board.kicad_sch, main-board.kicad_pcb]
2025-08-24 Position board-to-board connectors
    [left-board.kicad_pcb, main-board.kicad_pcb, right-board.kicad_pcb]
2025-08-24 Update pictures
    [main-board.kicad_pcb]
2025-08-24 Update renders
    [left-board.kicad_pcb, main-board.kicad_pcb, right-board.kicad_pcb]
