enigmr/game-console-1/(notices)

Notices in the files:
projects/kicad-libraries/3d-models/USB4105-GF-A.stp:
author */ ('License CC BY-ND 4.0'),
